BrunoCoelho98/maquete-iot-cidades-inteligentes/atividade/documentos/Questionario_antes.docx

Questionário — Internet das Coisas

Aplicação: antes da atividade

ANTES DE COMEÇAR

- Isto não é prova e não vale nota. Queremos saber o que a atividade ensina — não avaliar você.
- Se não souber uma resposta, marque Não sei. Isso ajuda muito mais do que um chute.
- Responda sem ajuda e sem consultar nada.

## Parte A — Marque uma alternativa

1. O que é a Internet das Coisas (IoT)?

( ) a) Usar a internet no celular, no computador e na televisão, em qualquer lugar da casa.

( ) b) Um aplicativo que liga e desliga, pelo celular, todos os aparelhos elétricos de uma casa.

( ) c) Objetos do dia a dia que percebem o ambiente, trocam informações pela rede e podem agir.

( ) d) A rede de computadores que as grandes empresas de tecnologia usam para guardar seus dados.

( ) Não sei

2. Em um sistema de IoT, qual destes é um SENSOR?

( ) a) Uma lâmpada que acende.

( ) b) Um motor que abre um portão.

( ) c) Uma sirene que toca.

( ) d) Um detector de presença.

( ) Não sei

3. E qual destes é um ATUADOR?

( ) a) Uma luz que acende para avisar.

( ) b) Um termômetro digital de parede.

( ) c) Um botão de campainha na porta.

( ) d) Um sensor de chuva no telhado.

( ) Não sei

4. Qual é o papel de um microcontrolador, como o ESP32, dentro de um objeto inteligente?

( ) a) Guardar a energia que o circuito usa, como uma bateria, para ele funcionar sem tomada.

( ) b) Executar um programa que lê os sensores, decide o que fazer e comanda os atuadores.

( ) c) Mostrar as informações em uma tela, para que o usuário acompanhe o que acontece.

( ) d) Transformar a energia elétrica em luz, calor ou movimento, conforme o que estiver ligado.

( ) Não sei

5. Como o microcontrolador sabe o que fazer?

( ) a) Ele aprende sozinho, observando o ambiente ao redor.

( ) b) Ele copia o que os outros aparelhos da rede estão fazendo.

( ) c) Ele já sai da fábrica sabendo controlar qualquer coisa.

( ) d) Alguém grava nele um programa com as instruções.

( ) Não sei

6. Um sensor de vaga de estacionamento fica a 200 metros da central da prefeitura, sem nenhum fio ligando os dois. Como a informação chega até a central?

( ) a) Por uma rede sem fio, como o Wi-Fi.

( ) b) Não chega: sem fio, não existe comunicação.

( ) c) Alguém precisa ir até o sensor buscar a informação.

( ) d) Pelo GPS do celular de quem estacionou.

( ) Não sei

7. Em um sistema que usa o protocolo MQTT, o que é o broker?

( ) a) O sensor que mede a informação e a transforma em uma mensagem para ser enviada.

( ) b) O roteador de Wi-Fi, que espalha o sinal da internet para os aparelhos da casa.

( ) c) Um intermediário que recebe as mensagens e as entrega a quem pediu para recebê-las.

( ) d) O programa que recebe os números e desenha os gráficos e os botões na tela do painel.

( ) Não sei

8. Uma lixeira inteligente publica a mensagem CHEIA no tópico cidade/lixeira/estado. Quem recebe essa mensagem?

( ) a) Todos os aparelhos que estão conectados à internet.

( ) b) Só quem assinou o tópico cidade/lixeira/estado.

( ) c) Só o celular de quem mora mais perto da lixeira.

( ) d) Ninguém: ela fica guardada na lixeira até alguém buscar.

( ) Não sei

9. Para que serve o tópico de uma mensagem MQTT?

( ) a) Para proteger a mensagem com uma senha, de modo que ninguém de fora da rede consiga ler.

( ) b) Para medir a velocidade da internet no momento em que a mensagem é enviada.

( ) c) Para registrar o dia e a hora em que a mensagem foi enviada pelo aparelho.

( ) d) Para dizer o assunto da mensagem, para que ela chegue a quem se interessa por ele.

( ) Não sei

10. No painel de uma cidade inteligente, alguém clica em um botão na tela e uma luz acende lá na rua. Isso mostra que:

( ) a) a informação só consegue ir da rua para o painel, e nunca no sentido contrário, do painel para a rua.

( ) b) o painel está ligado à luz por um fio comprido, escondido embaixo da calçada.

( ) c) a informação pode ir nos dois sentidos: da rua para o painel e do painel para a rua.

( ) d) a luz tem uma pequena câmera que viu a pessoa clicar no botão da tela.

( ) Não sei

11. O painel da cidade mostra que um dos aparelhos está OFFLINE. O que isso provavelmente quer dizer?

( ) a) O aparelho perdeu a conexão com a central: foi desligado, ficou sem Wi-Fi ou travou.

( ) b) O aparelho está funcionando normalmente, só que ninguém está usando ele agora.

( ) c) O aparelho está economizando energia de propósito e volta sozinho quando precisar.

( ) d) O painel está com defeito e mostra a informação errada para todos os aparelhos.

( ) Não sei

12. Uma cidade quer acrescentar um serviço novo a um sistema de IoT que já funciona. Em um sistema bem projetado:

( ) a) é preciso desligar e reprogramar todos os outros aparelhos da cidade para aceitar o novo.

( ) b) basta o novo aparelho seguir as mesmas regras de comunicação que os outros já seguem.

( ) c) o novo aparelho precisa ser ligado por fio a cada um dos aparelhos que já existem.

( ) d) é impossível: um sistema só funciona com os aparelhos que vieram com ele de fábrica.

( ) Não sei

## Parte B — Responda com as suas palavras

13. Em um ponto de ônibus inteligente, um passageiro aperta um botão e, pouco depois, aparece um aviso na tela da central. Numere de 1 a 5 a ordem em que a informação viaja:

Nº | Passo
| O broker recebe a mensagem e a entrega a quem assinou aquele tópico.
| O passageiro aperta o botão.
| A tela da central mostra "passageiro aguardando".
| O microcontrolador percebe o botão e publica uma mensagem pelo Wi-Fi.
| O programa da central (por exemplo, o Node-RED) recebe a mensagem.

14. Uma prefeitura quer lixeiras que avisem a central quando estiverem cheias. Cada lixeira também tem uma luz, que a central acende quando o caminhão de coleta está a caminho. Nesse sistema:

a) Qual é o sensor?

b) Qual é o atuador?

c) Invente um nome de tópico para a lixeira avisar que está cheia.

d) Que mensagem a central mandaria para a lixeira quando o caminhão sair?

15. Explique com as suas palavras o que acontece desde o momento em que alguém aperta o botão de um ponto de ônibus inteligente até a luz do ponto piscar, avisando que o ônibus está vindo.

## Parte C — Quanto você se sente capaz

Marque um número: 1 = nada confiante · 5 = muito confiante.

Eu conseguiria explicar para um colega… | 1 | 2 | 3 | 4 | 5
C1 o que é a Internet das Coisas. | ○ | ○ | ○ | ○ | ○
C2 a diferença entre um sensor e um atuador. | ○ | ○ | ○ | ○ | ○
C3 o que faz um microcontrolador. | ○ | ○ | ○ | ○ | ○
C4 como uma mensagem sai de um aparelho e chega a um painel na tela. | ○ | ○ | ○ | ○ | ○
C5 o que são o broker e o tópico no MQTT. | ○ | ○ | ○ | ○ | ○

Eu conseguiria… | 1 | 2 | 3 | 4 | 5
C6 montar um circuito simples seguindo um passo a passo. | ○ | ○ | ○ | ○ | ○

Obrigado!

Mini Smart City · Questionário · aplicação PRÉ · página 1
