BrunoCoelho98/maquete-iot-cidades-inteligentes/atividade/figuras/caminho_mensagem.png

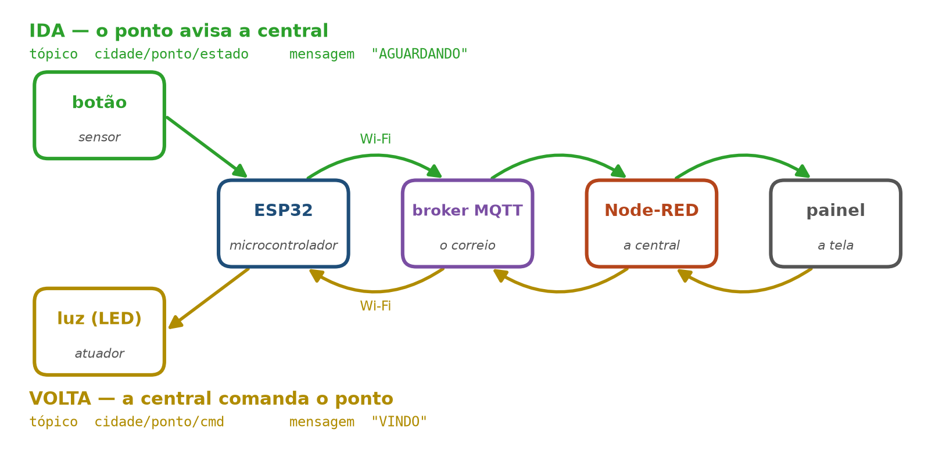
atividade/figuras/caminho_mensagem.png
