BrunoCoelho98/maquete-iot-cidades-inteligentes/esquematicos/png/placa1A_sinaleiras.png

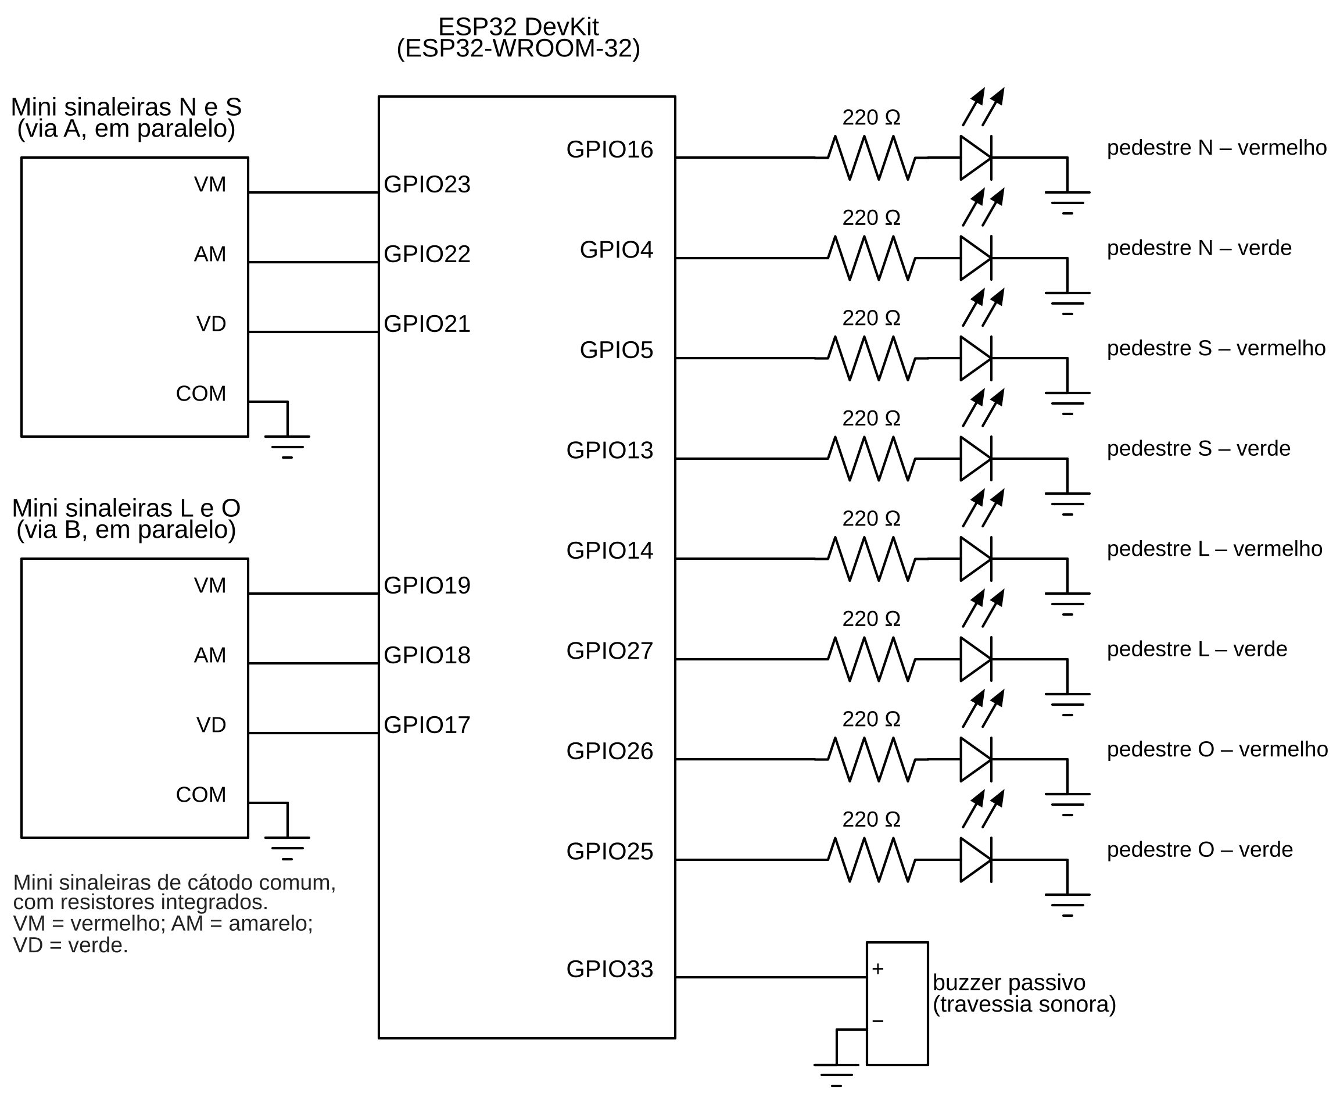
esquematicos/png/placa1A_sinaleiras.png
