BrunoCoelho98/maquete-iot-cidades-inteligentes/esquematicos/png/placa1B_sensores.png

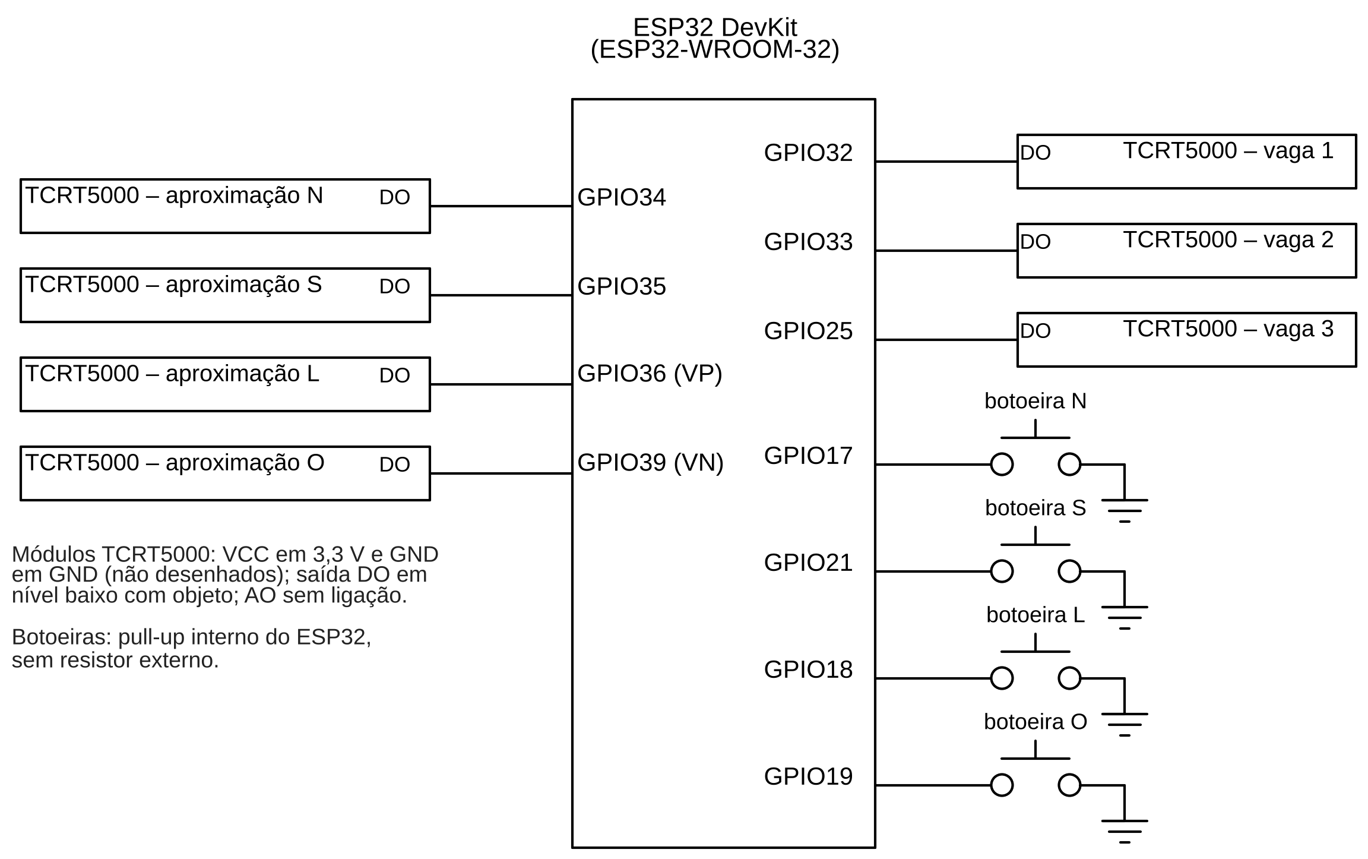
esquematicos/png/placa1B_sensores.png
