BrunoCoelho98/maquete-iot-cidades-inteligentes/esquematicos/png/placa2_iluminacao.png

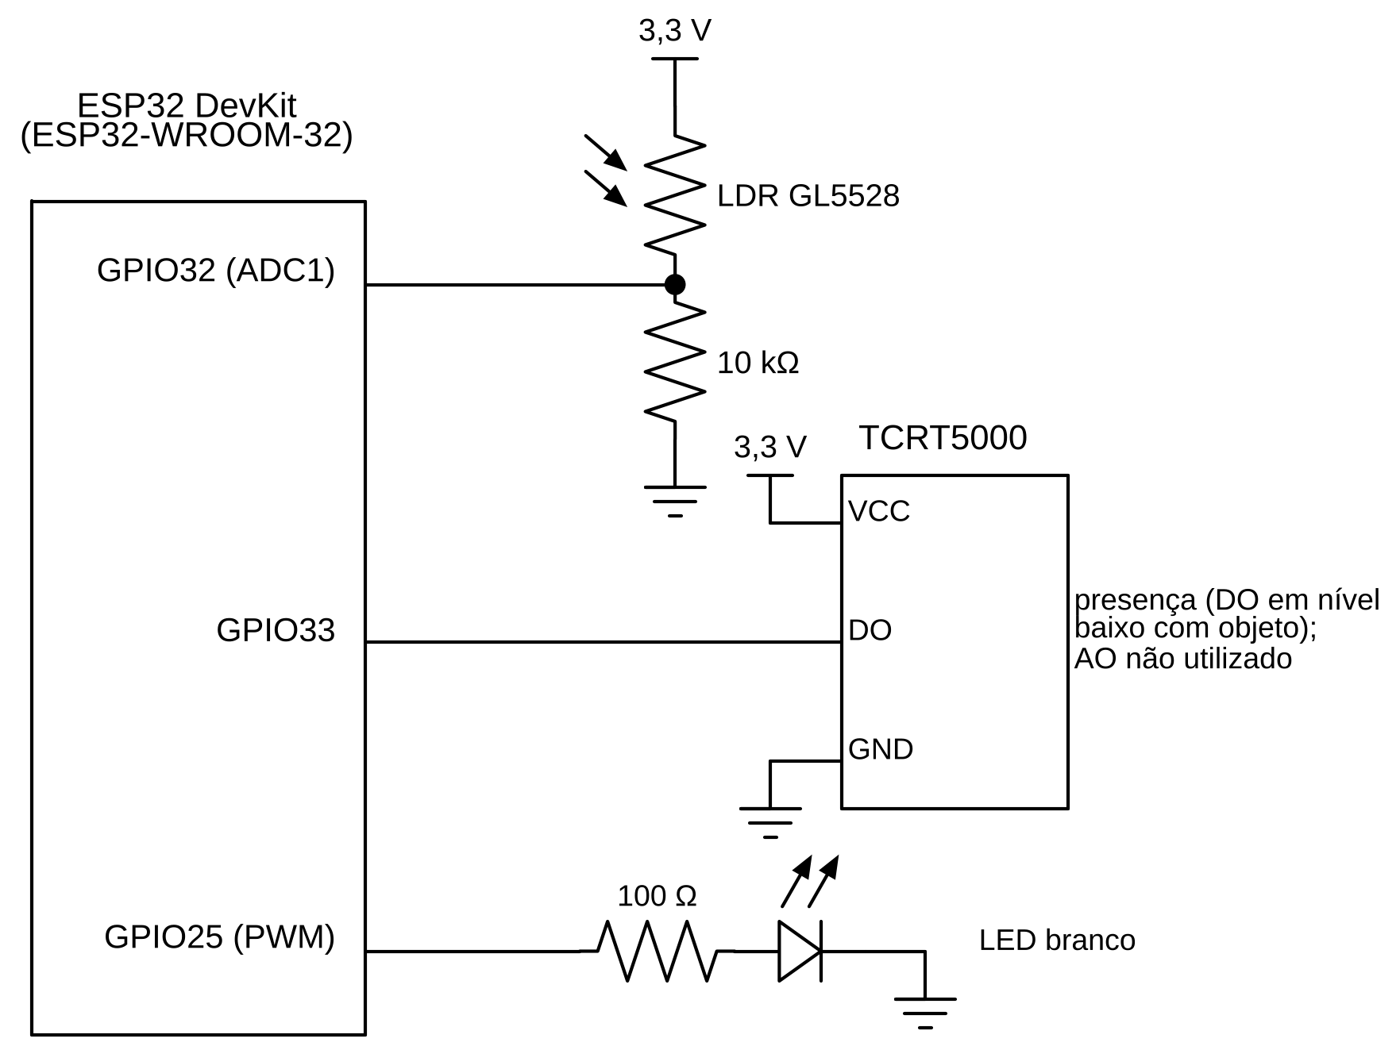
esquematicos/png/placa2_iluminacao.png
