BrunoCoelho98/maquete-iot-cidades-inteligentes/esquematicos/png/placa3_ambiental.png

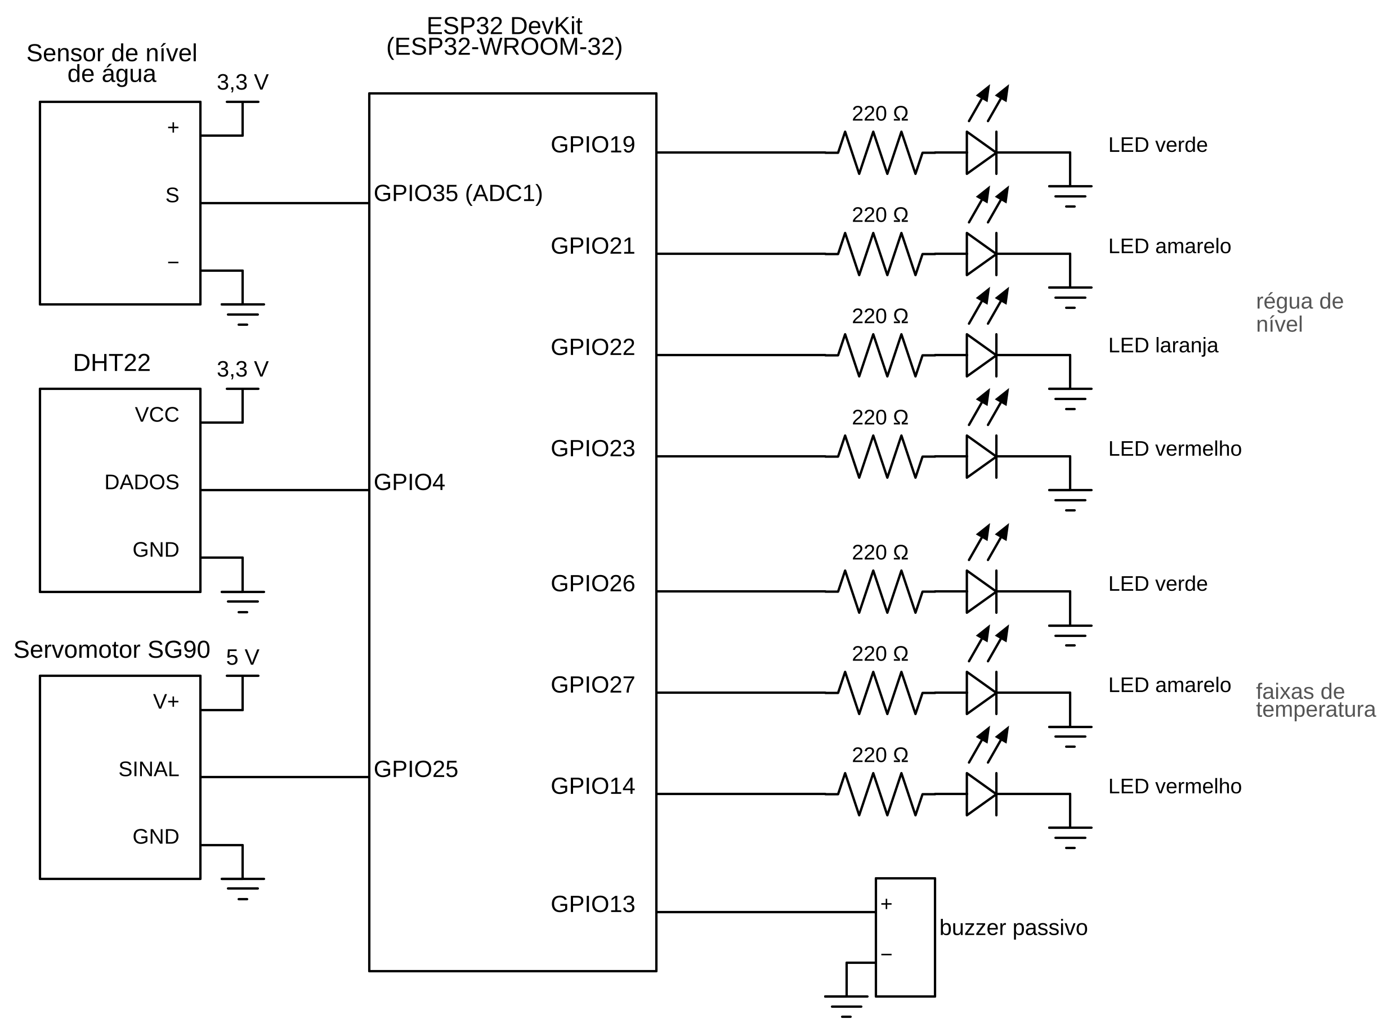
esquematicos/png/placa3_ambiental.png
