BrunoCoelho98/maquete-iot-cidades-inteligentes/esquematicos/png/placa4_seguranca.png

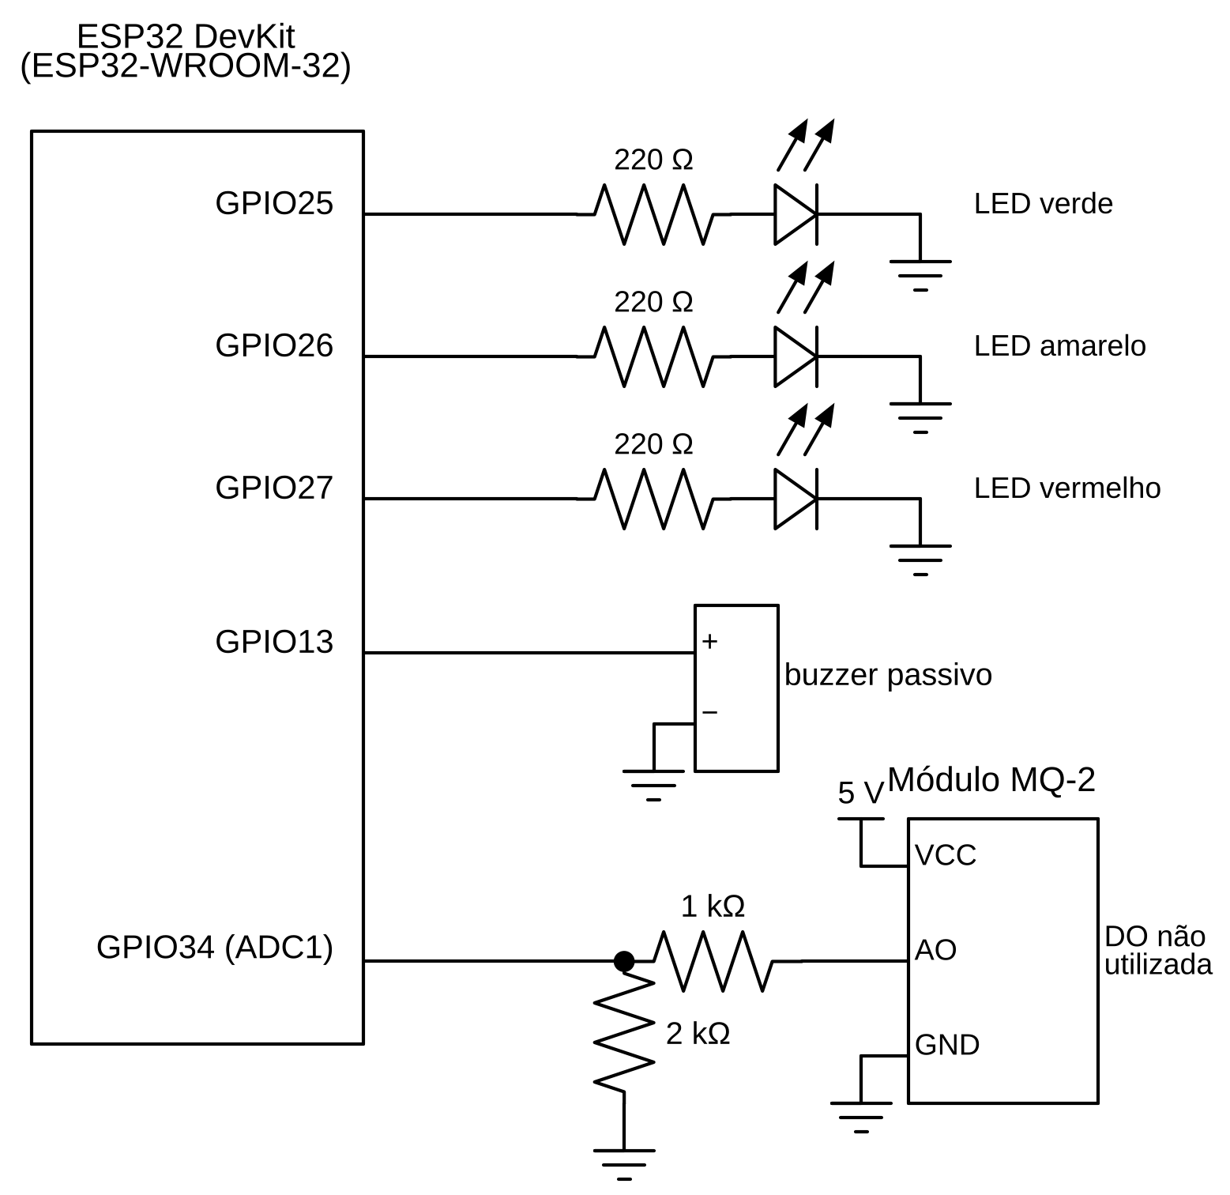
esquematicos/png/placa4_seguranca.png
