BrunoCoelho98/maquete-iot-cidades-inteligentes/layout/placa1A_1_veiculos.png

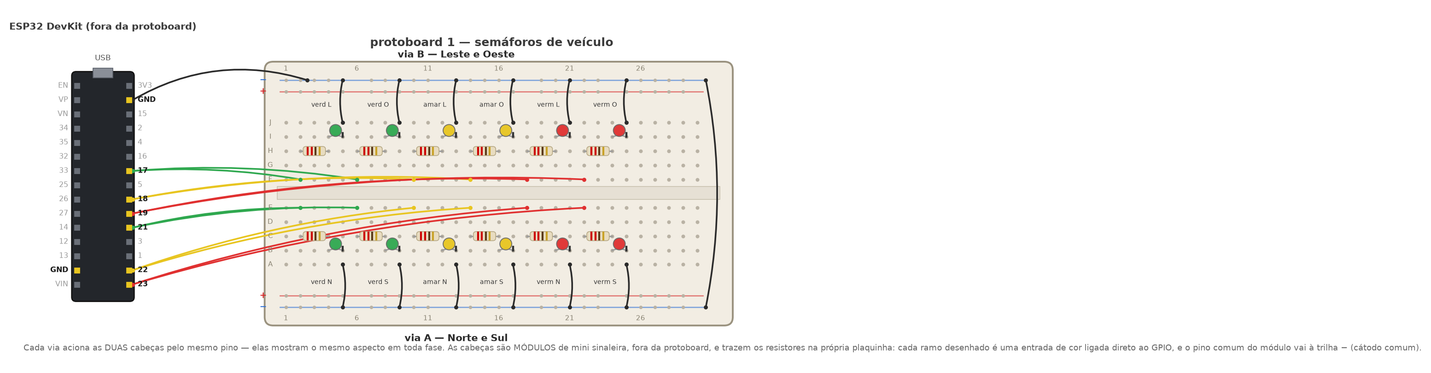
layout/placa1A_1_veiculos.png
