BrunoCoelho98/maquete-iot-cidades-inteligentes/layout/placa1A_2_pedestres.png

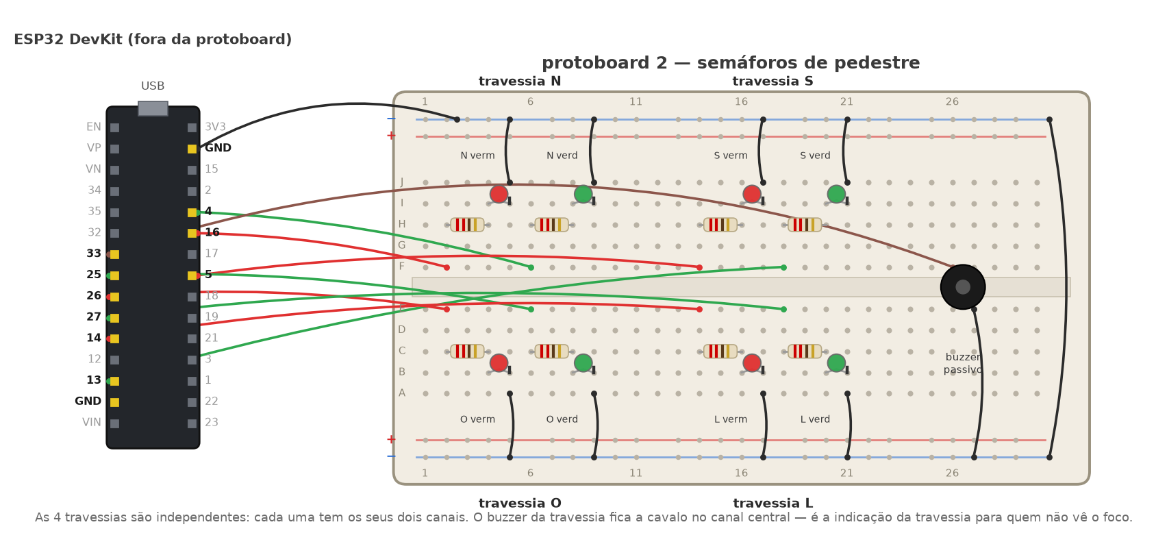
layout/placa1A_2_pedestres.png
