BrunoCoelho98/maquete-iot-cidades-inteligentes/esquematicos/pdf/iluminacao.pdf

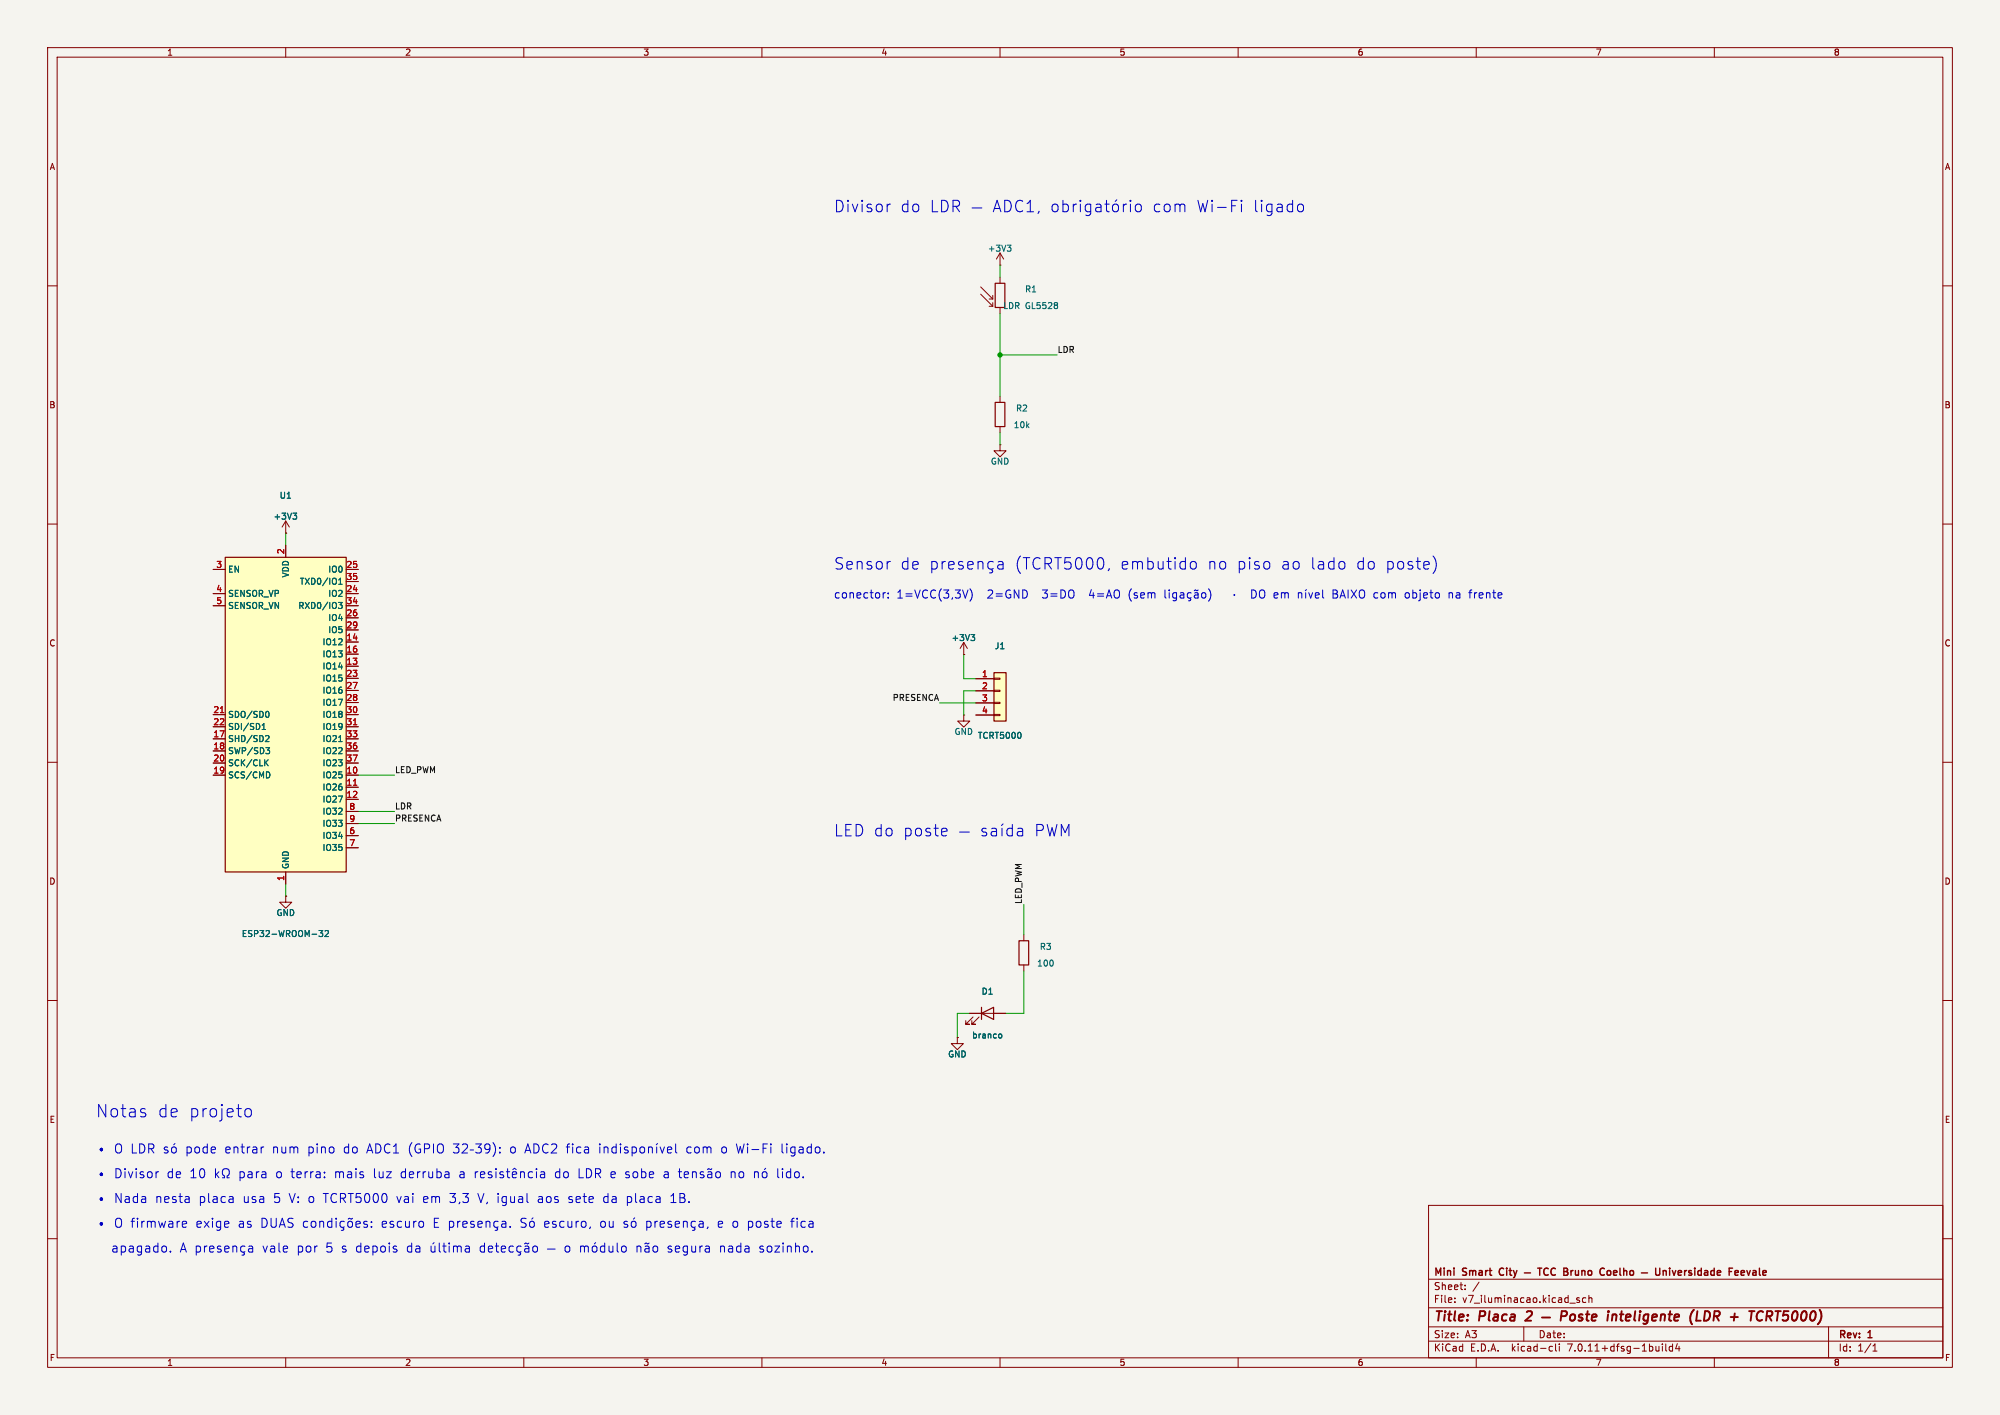
[picture p29: page 1]

Divisor do LDR þÿ ADC1, þÿobrigatório com Wi-Fi ligado

2 SCK/CLK 20 SDO/SD0 21 SDI/SD1 22

Sensor de þÿpresença (TCRT5000, embutido no piso ao lado do poste)

LED do poste þÿ þÿsaída PWM

þÿ "O LDR þÿsópode entrar num pino do ADC1 (GPIO þÿ32 39): o ADC2 fica þÿindisponível com o Wi-Fi ligado.
þÿ "Divisor de 10 þÿk©para o terra: mais luz derruba a þÿresistência do LDR e sobe a þÿtensão no þÿnólido.
þÿ "Nada nesta placa usa 5 V: o TCRT5000 vai em 3,3 V, igual aos sete da placa 1B.
þÿ "O firmware exige as DUAS þÿcondições: escuro E þÿpresença. þÿSóescuro, ou þÿsóþÿpresença, e o poste fica
apagado. A þÿpresença vale por 5 s depois da þÿúltima þÿdetecção þÿ  þÿmódulo þÿnãosegura nada sozinho.
