BrunoCoelho98/maquete-iot-cidades-inteligentes/esquematicos/pdf/seguranca.pdf

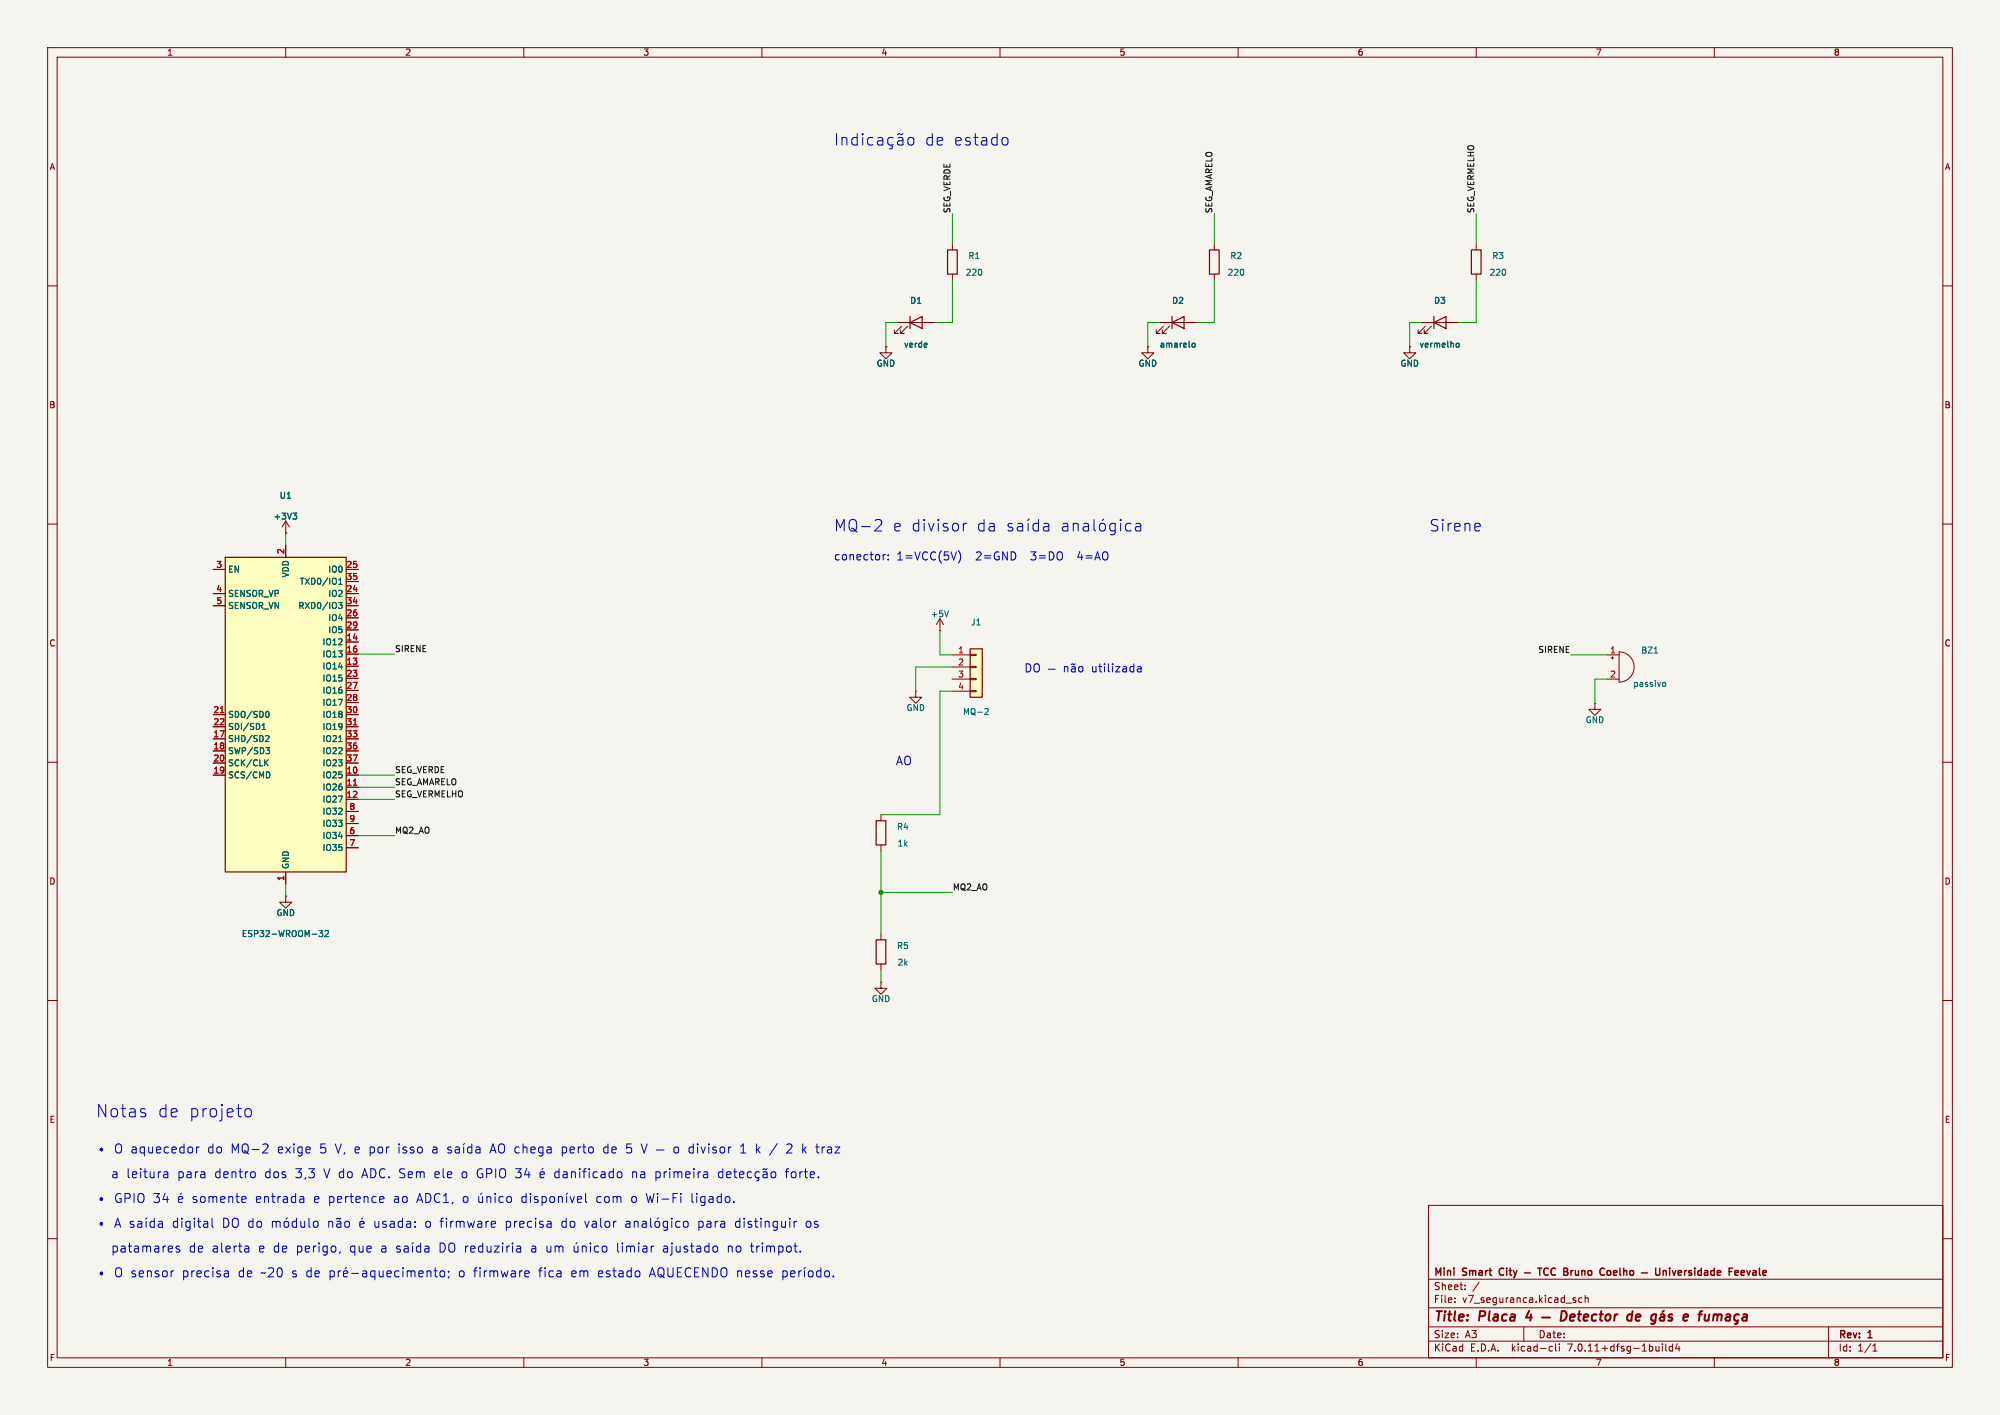
[picture p30: page 1]

MQ-2 e divisor da þÿsaída þÿanalógica

2 SCK/CLK 20 SDO/SD0 21 SDI/SD1 22

DO þÿ þÿnãoutilizada

þÿ "O aquecedor do MQ-2 exige 5 V, e por isso a þÿsaída AO chega perto de 5 V þÿ o divisor 1 k / 2 k traz

þÿ "O sensor precisa de ~20 s de þÿpré-aquecimento; o firmware fica em estado AQUECENDO nesse þÿperíodo.

File: v7_seguranca.kicad_sch Sheet: / Mini Smart City þÿ TCC Bruno Coelho þÿ Universidade Feevale

Id: 1/1 Title: Placa 4 þÿ Detector de þÿgáse þÿfumaça
