BrunoCoelho98/maquete-iot-cidades-inteligentes/esquematicos/pdf/sensores.pdf

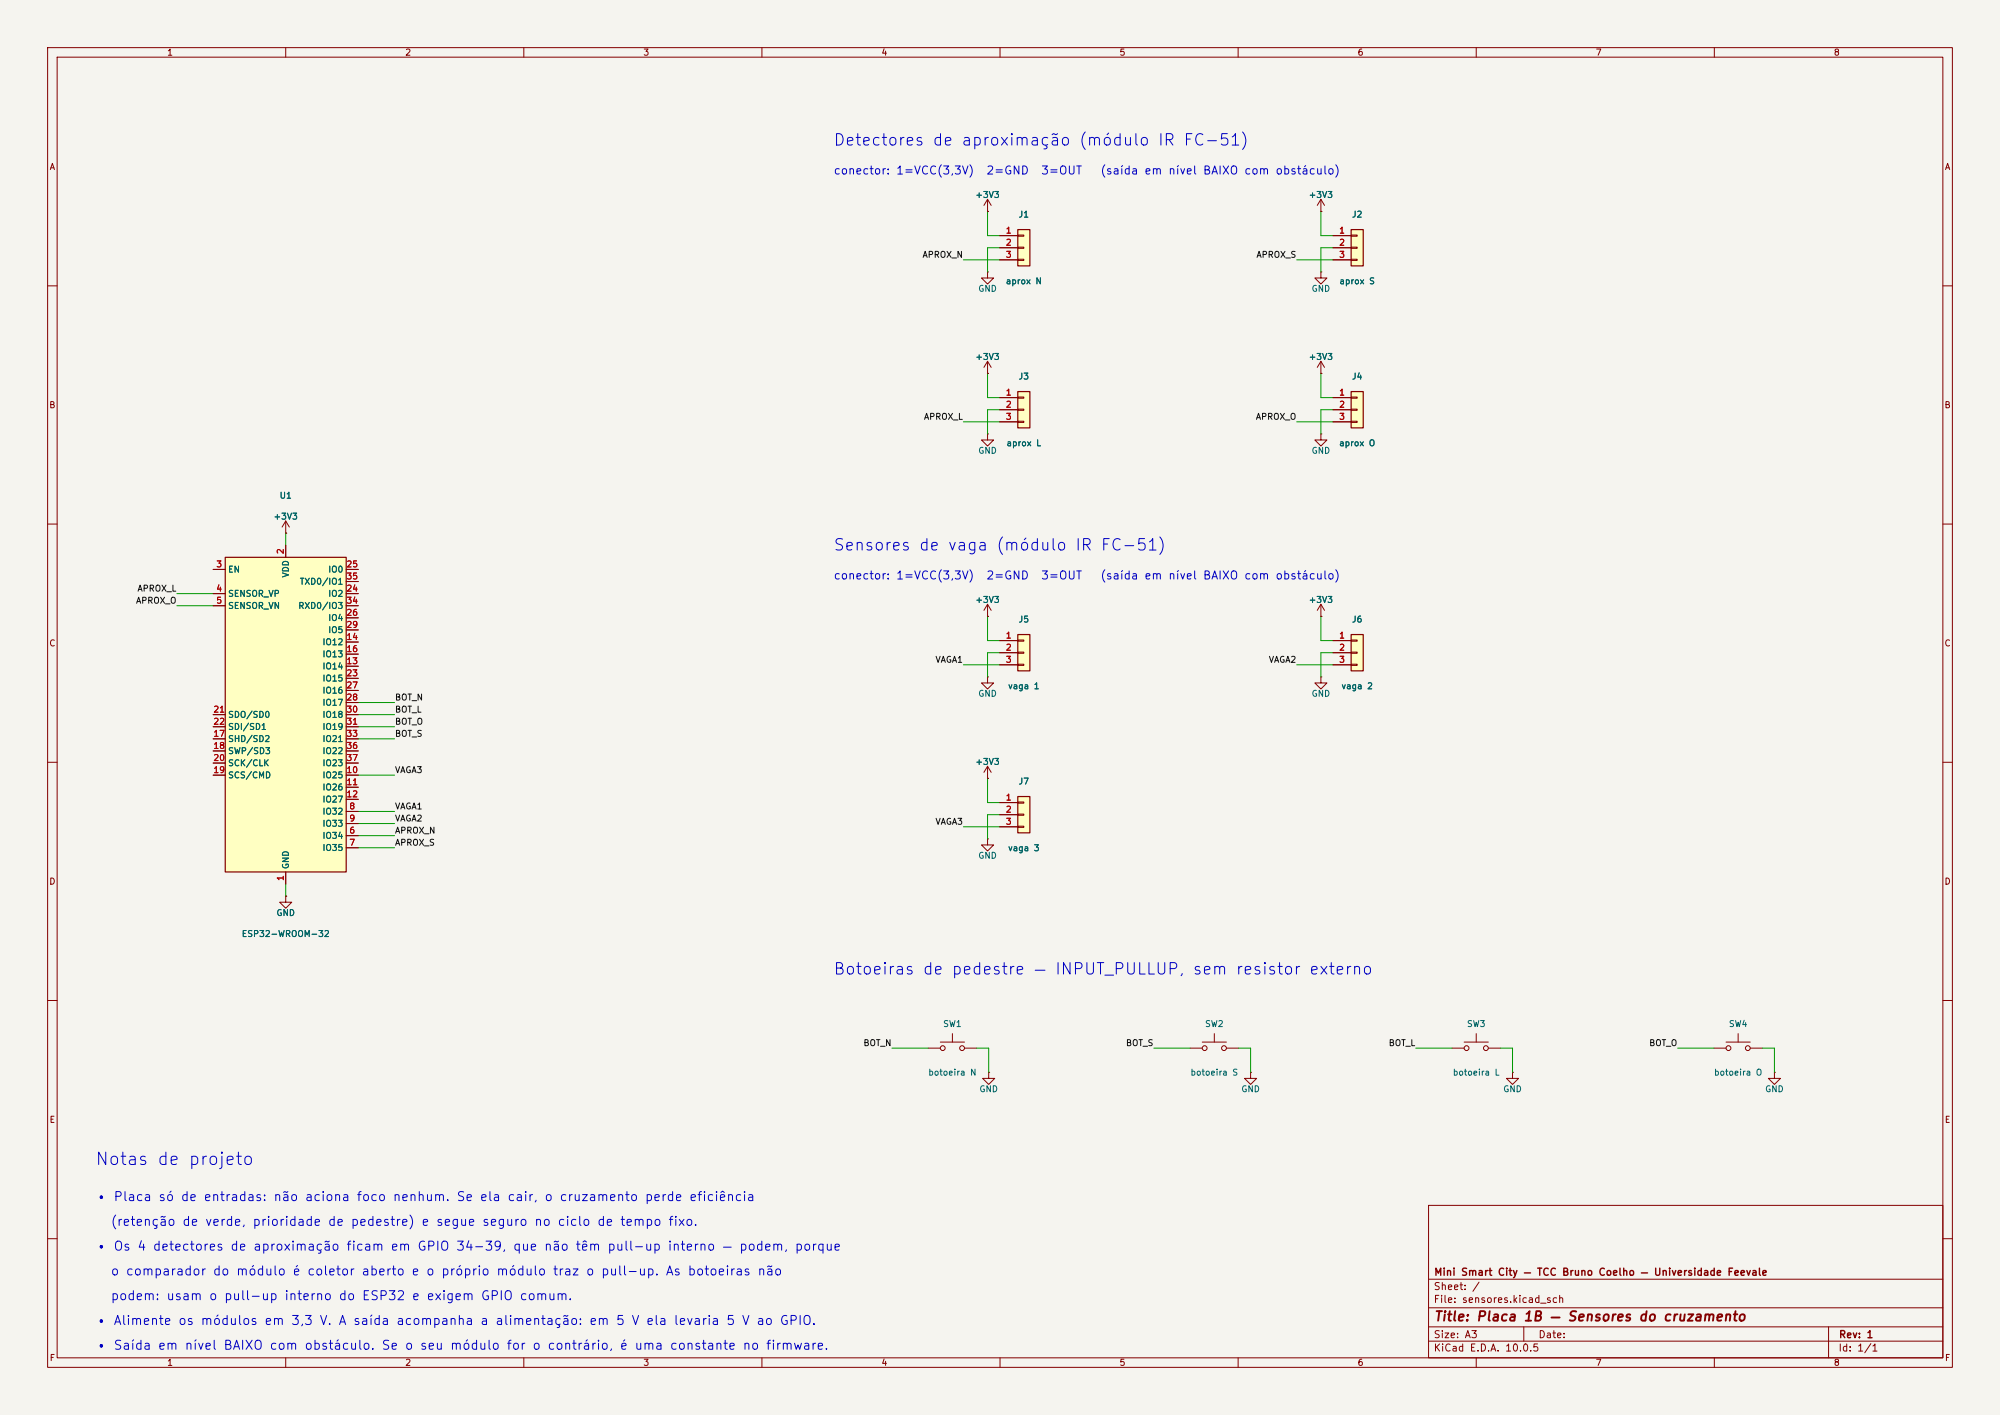
[picture p32: page 1]

Detectores de aproximação (módulo IR FC-51)

Sensores de vaga (módulo IR FC-51)

Botoeiras de pedestre — INPUT_PULLUP, sem resistor externo • Os 4 detectores de aproximação ficam em GPIO 34-39, que não têm pull-up interno — podem, porque

podem: usam o pull-up interno do ESP32 e exigem GPIO comum. • Placa só de entradas: não aciona foco nenhum. Se ela cair, o cruzamento perde eficiência • Saída em nível BAIXO com obstáculo. Se o seu módulo for o contrário, é uma constante no firmware. o comparador do módulo é coletor aberto e o próprio módulo traz o pull-up. As botoeiras não

Mini Smart City — TCC Bruno Coelho — Universidade Feevale
Sheet: /
File: sensores.kicad_sch
Title: Placa 1B — Sensores do cruzamento

• Alimente os módulos em 3,3 V. A saída acompanha a alimentação: em 5 V ela levaria 5 V ao GPIO.

Size: A3 | Rev: 1 | F Date:
KiCad E.D.A. 10.0.5 | Id: 1/1
