BrunoCoelho98/maquete-iot-cidades-inteligentes/esquematicos/ambiental.kicad_sch

## KiCad design esquematicos/ambiental.kicad_sch (2026-11-01)

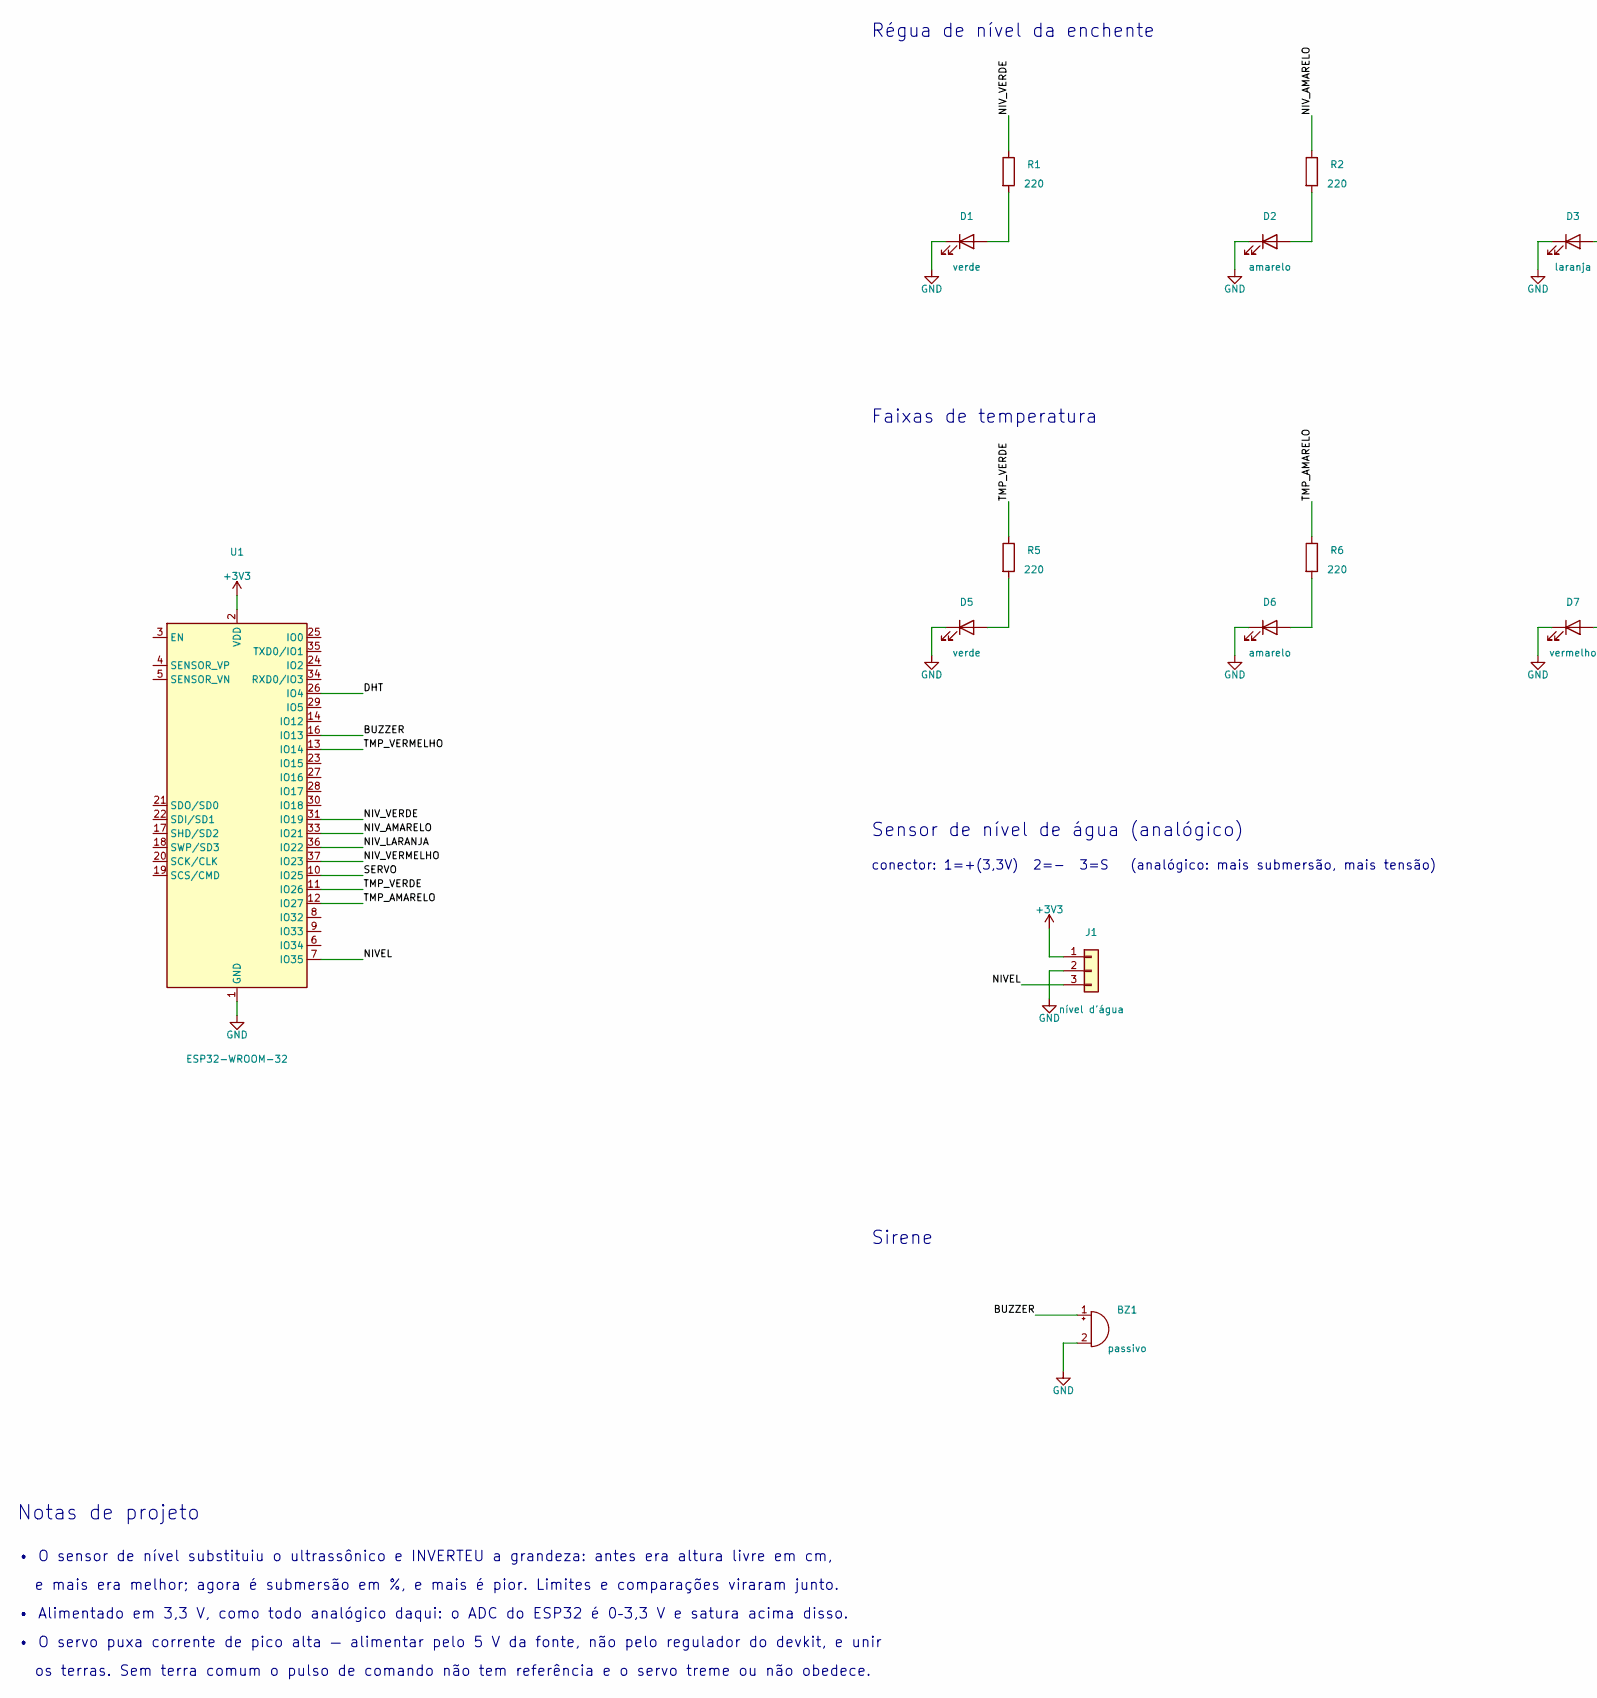
[picture p33: schematic ambiental.kicad_sch, part in row 1, column 1]

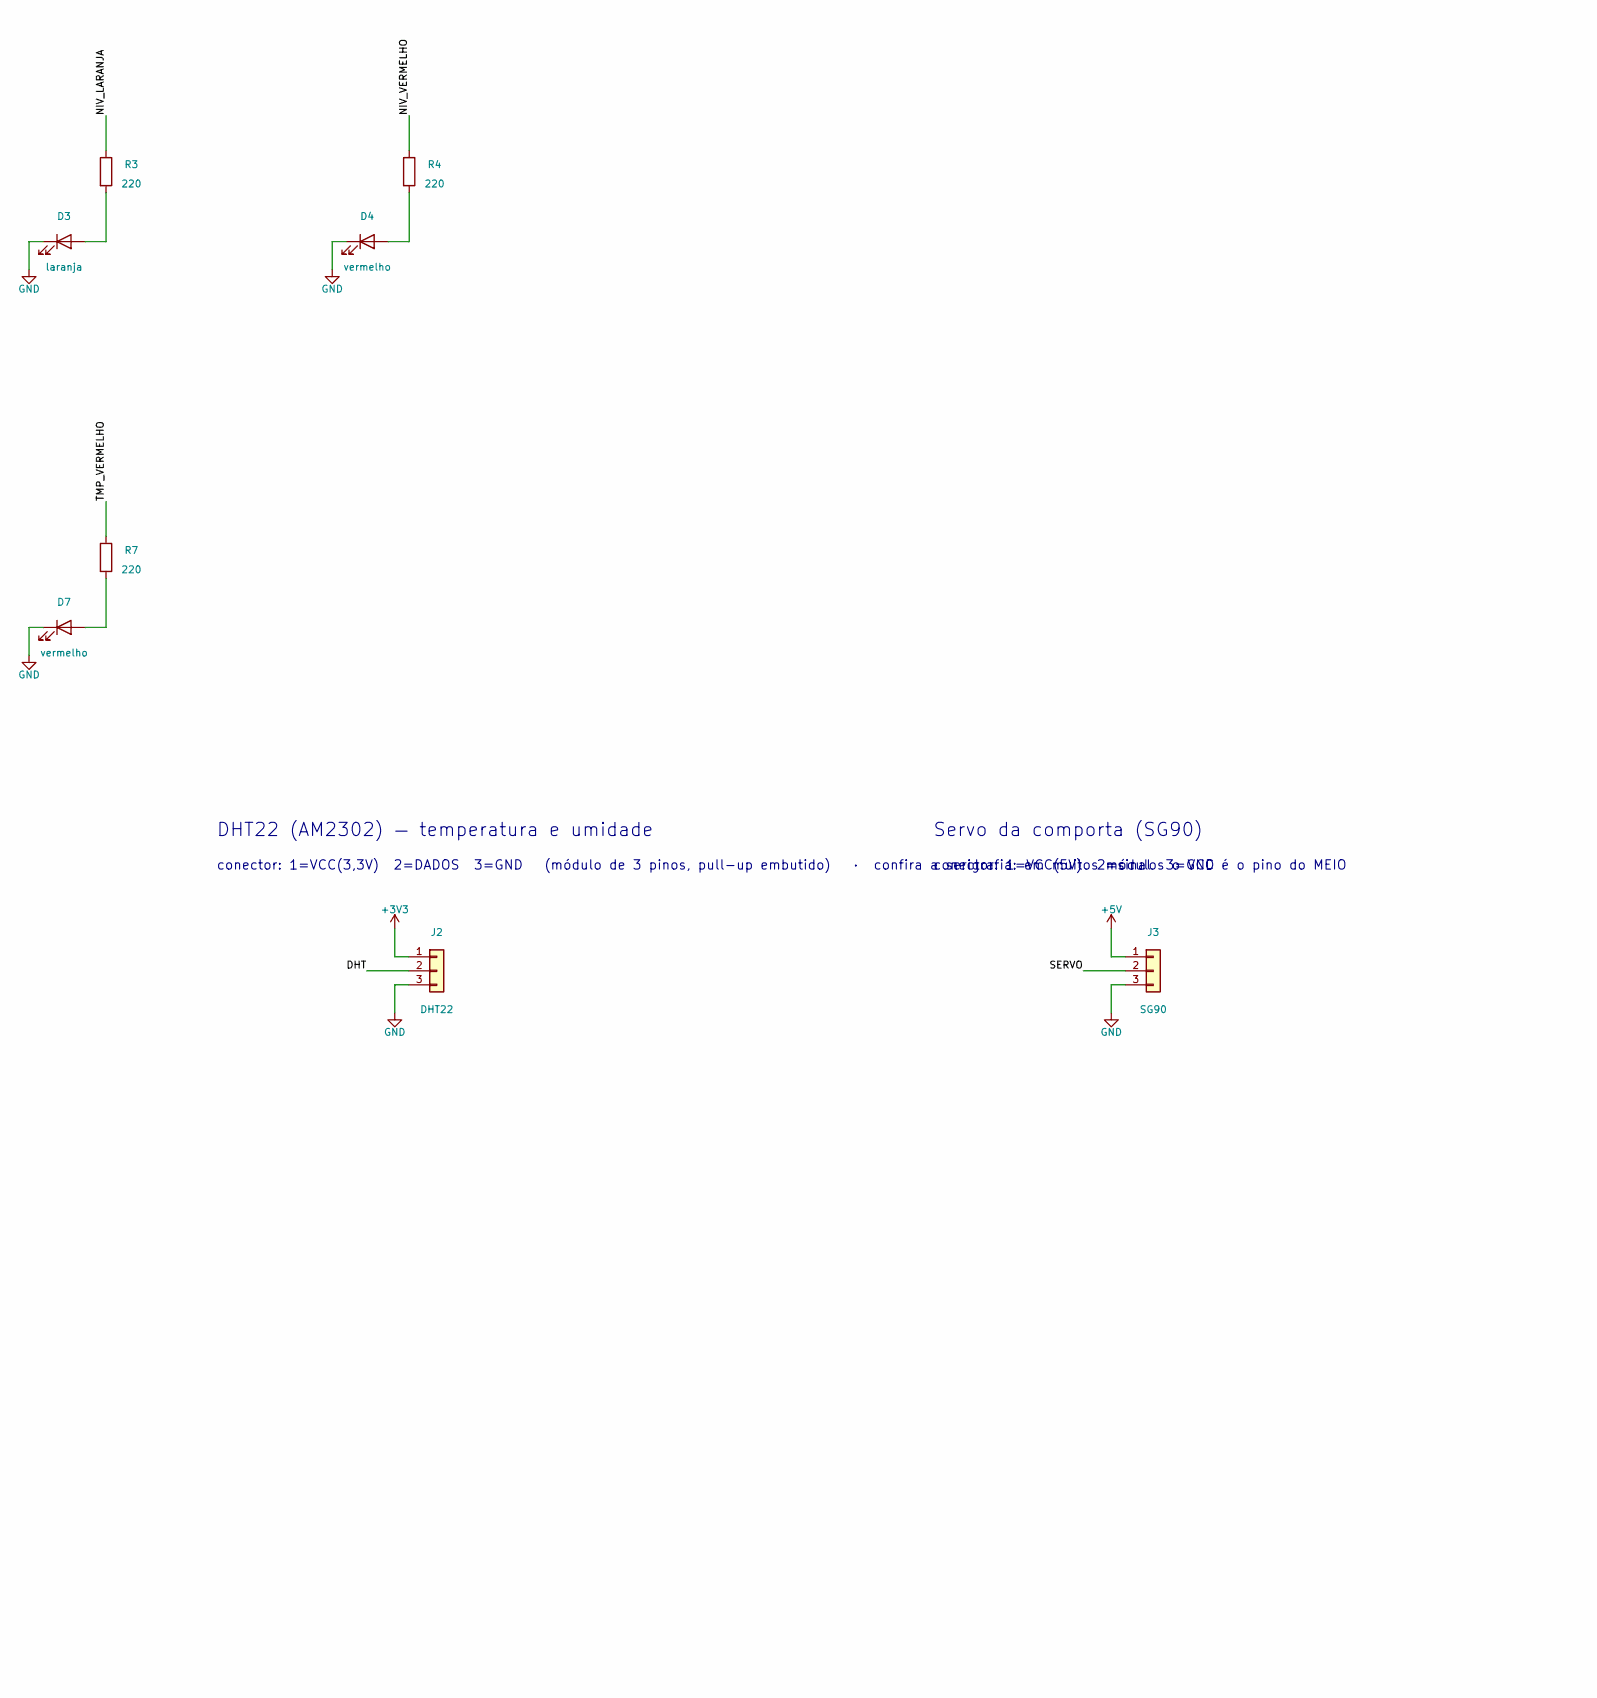
[picture p34: schematic ambiental.kicad_sch, part in row 1, column 2]

Parts:
BZ1: passivo
D1, D5: verde
D2, D6: amarelo
D3: laranja
D4, D7: vermelho
J1: nível d'água
J2: DHT22
J3: SG90
R1, R2, R3, R4, R5, R6, R7: 220
U1: ESP32-WROOM-32

Connections:
+3V3: J1.1, J2.1, U1.2 (VDD)
+5V: J3.1
BUZZER: BZ1.1 (+), U1.16 (IO13)
DHT: J2.2, U1.26 (IO4)
GND: BZ1.2 (-), D1.1 (K), D2.1 (K), D3.1 (K), D4.1 (K), D5.1 (K), D6.1 (K), D7.1 (K), J1.2, J2.3, J3.3, U1.1 (GND), U1.15 (GND), U1.38 (GND), U1.39 (GND)
NIVEL: J1.3, U1.7 (IO35)
NIV_AMARELO: R2.1, U1.33 (IO21)
NIV_LARANJA: R3.1, U1.36 (IO22)
NIV_VERDE: R1.1, U1.31 (IO19)
NIV_VERMELHO: R4.1, U1.37 (IO23)
unnamed: D1.2 (A), R1.2
unnamed: D2.2 (A), R2.2
unnamed: D3.2 (A), R3.2
unnamed: D4.2 (A), R4.2
unnamed: D5.2 (A), R5.2
unnamed: D6.2 (A), R6.2
unnamed: D7.2 (A), R7.2
SERVO: J3.2, U1.10 (IO25)
TMP_AMARELO: R6.1, U1.12 (IO27)
TMP_VERDE: R5.1, U1.11 (IO26)
TMP_VERMELHO: R7.1, U1.13 (IO14)

Notes on the sheet:
Régua de nível da enchente
Faixas de temperatura
Sensor de nível de água (analógico)
conector: 1=+(3,3V) 2=− 3=S (analógico: mais submersão, mais tensão)
DHT22 (AM2302) — temperatura e umidade
conector: 1=VCC(3,3V) 2=DADOS 3=GND (módulo de 3 pinos, pull-up embutido) · confira a serigrafia: em muitos módulos o VCC é o pino do MEIO
Servo da comporta (SG90)
conector: 1=VCC(5V) 2=sinal 3=GND
Sirene
Notas de projeto
• O sensor de nível substituiu o ultrassônico e INVERTEU a grandeza: antes era altura livre em cm,
e mais era melhor; agora é submersão em %, e mais é pior. Limites e comparações viraram junto.
• Alimentado em 3,3 V, como todo analógico daqui: o ADC do ESP32 é 0–3,3 V e satura acima disso.
• O servo puxa corrente de pico alta — alimentar pelo 5 V da fonte, não pelo regulador do devkit, e unir
os terras. Sem terra comum o pulso de comando não tem referência e o servo treme ou não obedece.
