BrunoCoelho98/maquete-iot-cidades-inteligentes/esquematicos/iluminacao.kicad_sch

## KiCad design esquematicos/iluminacao.kicad_sch (2026-11-10)

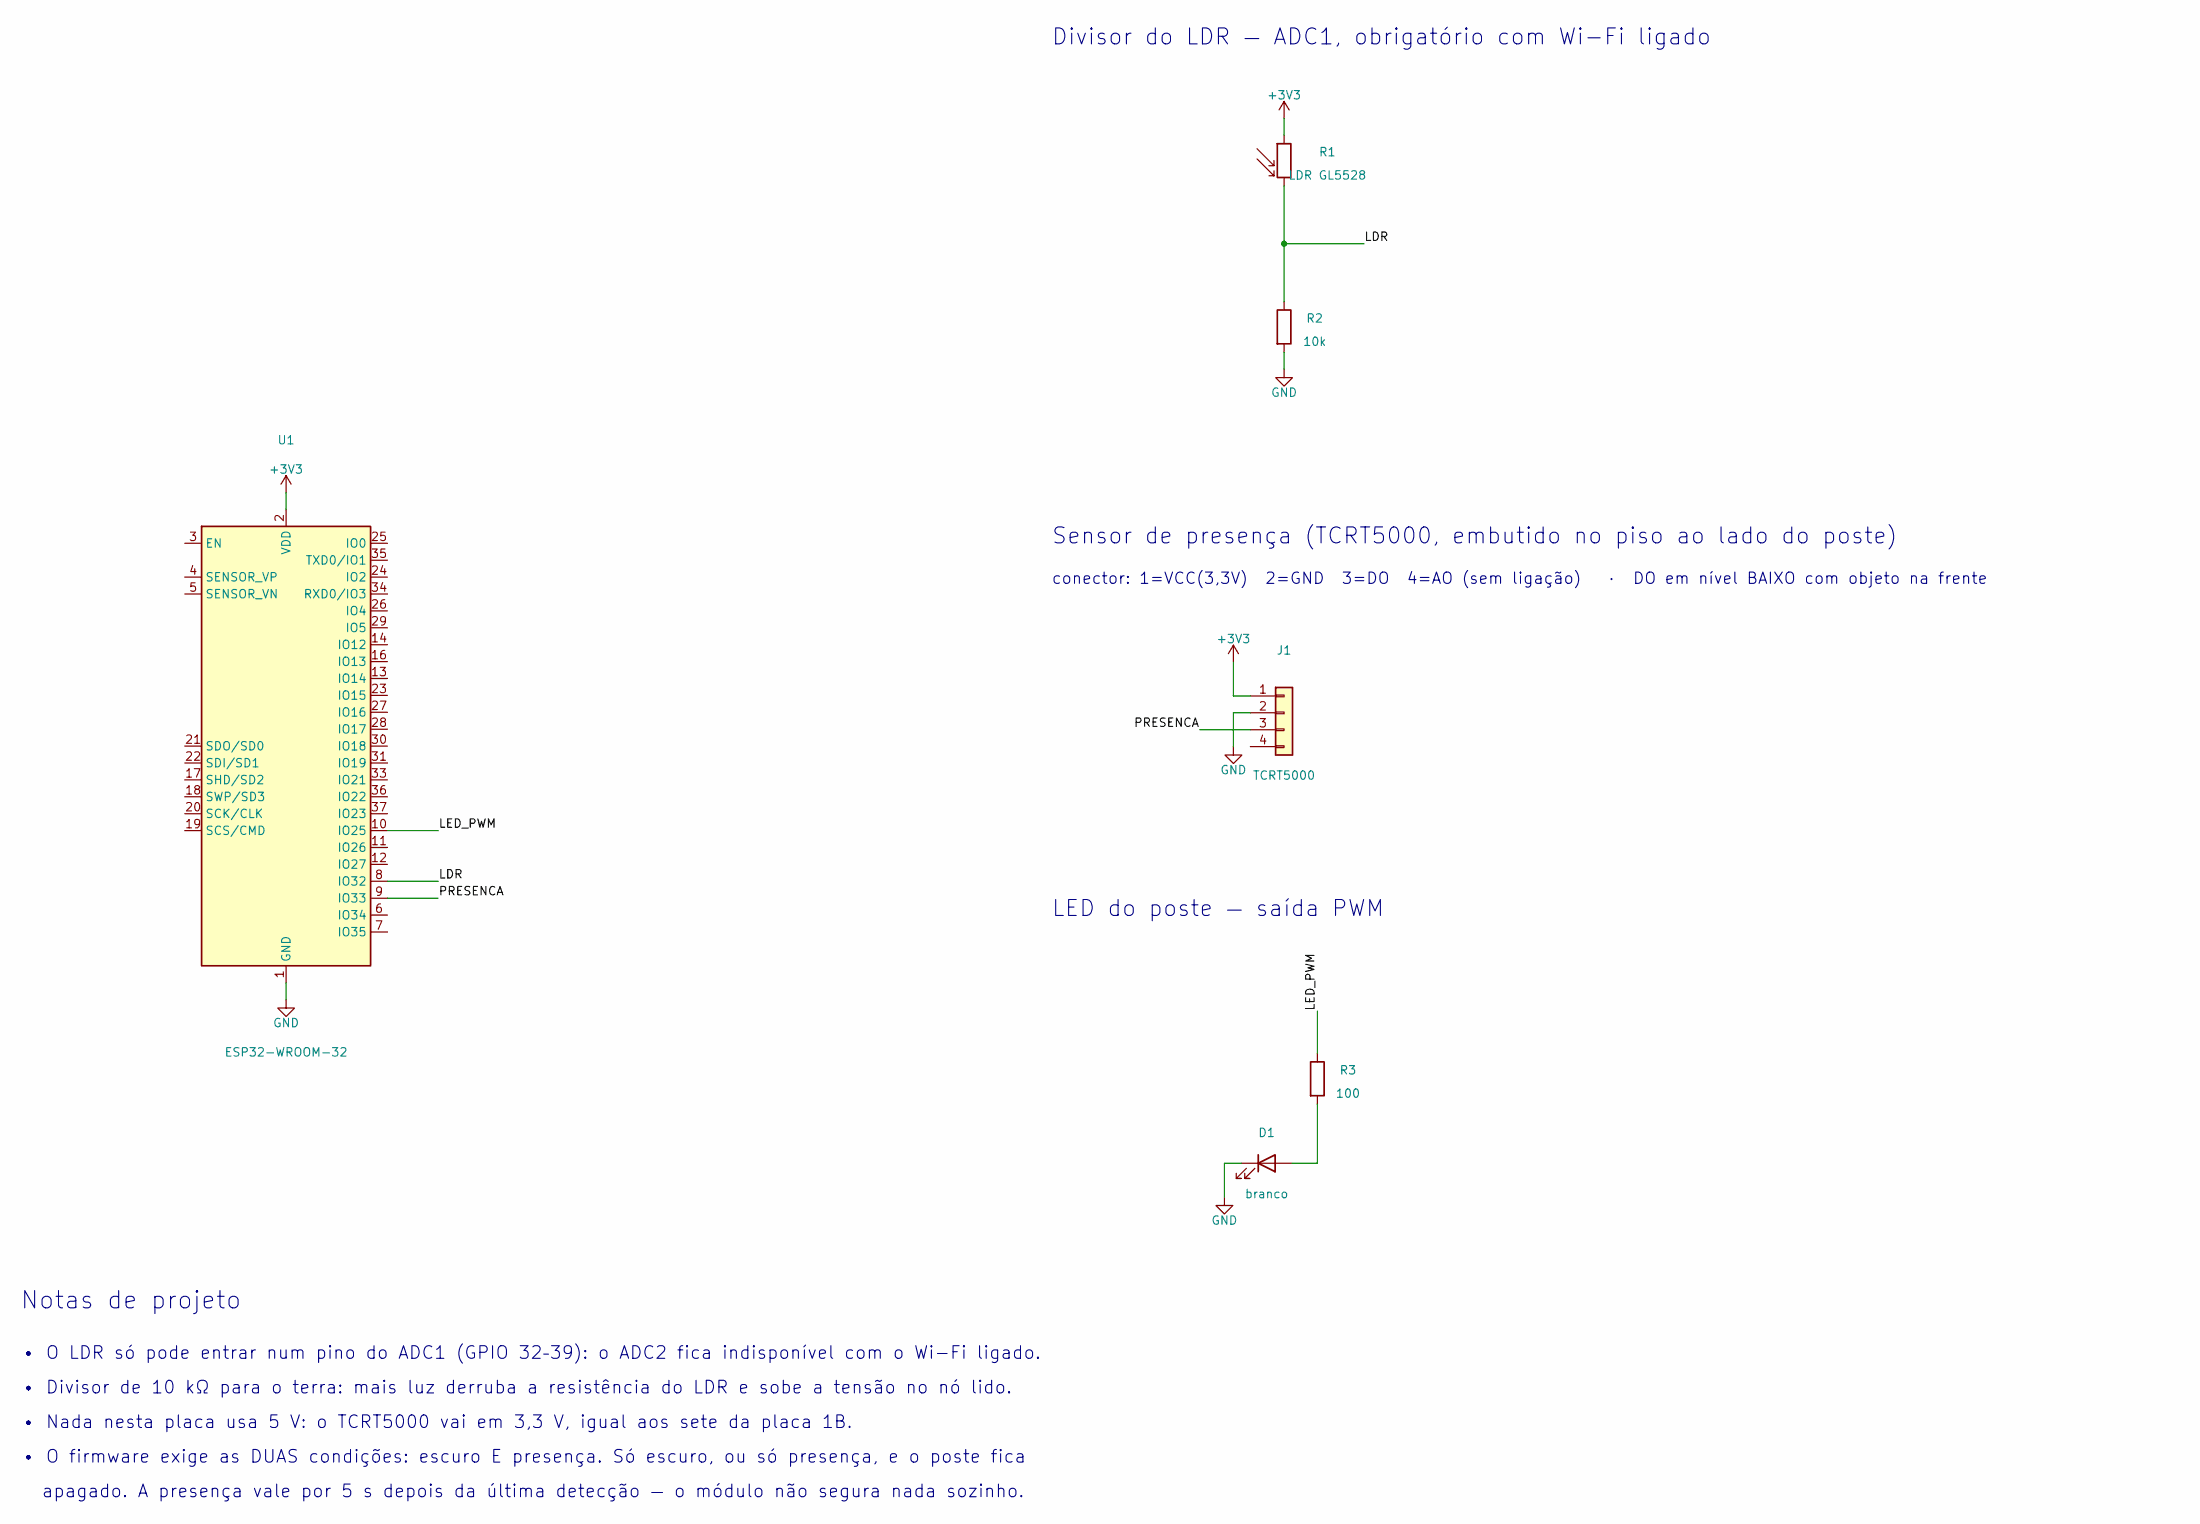
[picture p35: schematic iluminacao.kicad_sch]

Parts:
D1: branco
J1: TCRT5000
R1: LDR GL5528
R2: 10k
R3: 100
U1: ESP32-WROOM-32

Connections:
+3V3: J1.1, R1.1, U1.2 (VDD)
GND: D1.1 (K), J1.2, R2.2, U1.1 (GND), U1.15 (GND), U1.38 (GND), U1.39 (GND)
LDR: R1.2, R2.1, U1.8 (IO32)
LED_PWM: R3.1, U1.10 (IO25)
unnamed: D1.2 (A), R3.2
PRESENCA: J1.3, U1.9 (IO33)

Notes on the sheet:
Divisor do LDR — ADC1, obrigatório com Wi-Fi ligado
Sensor de presença (TCRT5000, embutido no piso ao lado do poste)
conector: 1=VCC(3,3V) 2=GND 3=DO 4=AO (sem ligação) · DO em nível BAIXO com objeto na frente
LED do poste — saída PWM
Notas de projeto
• O LDR só pode entrar num pino do ADC1 (GPIO 32–39): o ADC2 fica indisponível com o Wi-Fi ligado.
• Divisor de 10 kΩ para o terra: mais luz derruba a resistência do LDR e sobe a tensão no nó lido.
• Nada nesta placa usa 5 V: o TCRT5000 vai em 3,3 V, igual aos sete da placa 1B.
• O firmware exige as DUAS condições: escuro E presença. Só escuro, ou só presença, e o poste fica
apagado. A presença vale por 5 s depois da última detecção — o módulo não segura nada sozinho.
