BrunoCoelho98/maquete-iot-cidades-inteligentes/esquematicos/seguranca.kicad_sch

## KiCad design esquematicos/seguranca.kicad_sch (2026-11-10)

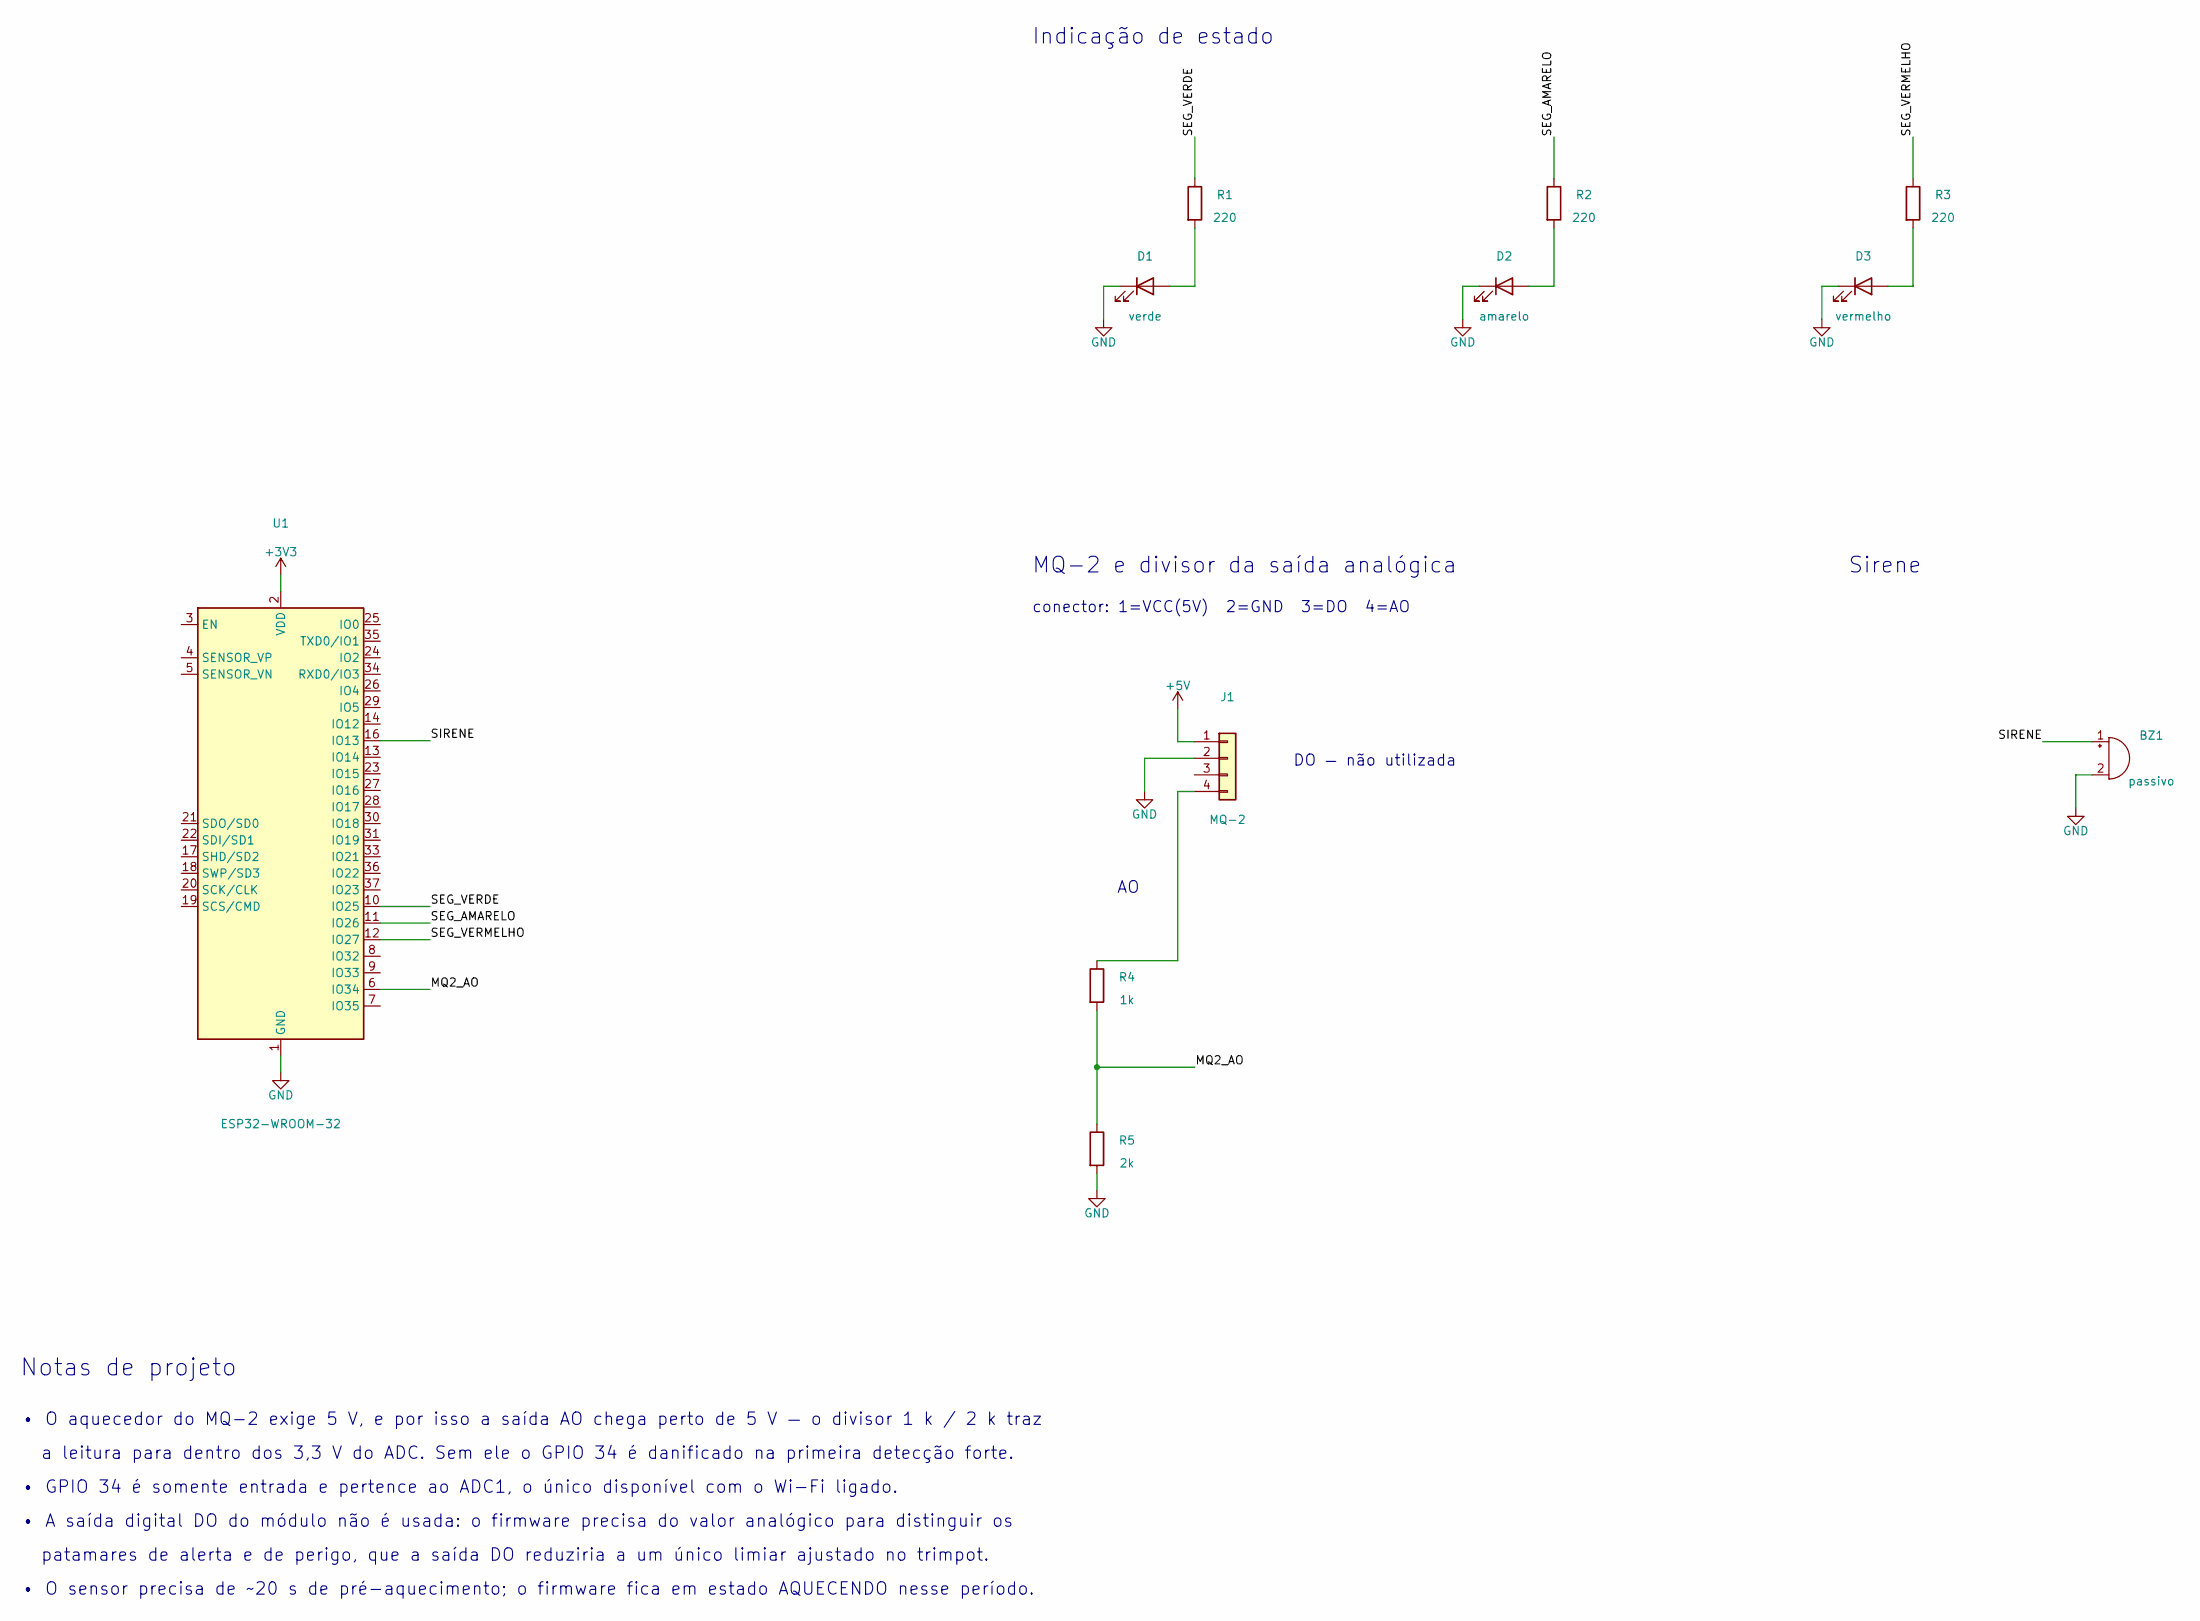
[picture p36: schematic seguranca.kicad_sch]

Parts:
BZ1: passivo
D1: verde
D2: amarelo
D3: vermelho
J1: MQ-2
R1, R2, R3: 220
R4: 1k
R5: 2k
U1: ESP32-WROOM-32

Connections:
+3V3: U1.2 (VDD)
+5V: J1.1
GND: BZ1.2 (-), D1.1 (K), D2.1 (K), D3.1 (K), J1.2, R5.2, U1.1 (GND), U1.15 (GND), U1.38 (GND), U1.39 (GND)
MQ2_AO: R4.2, R5.1, U1.6 (IO34)
unnamed: D1.2 (A), R1.2
unnamed: D2.2 (A), R2.2
unnamed: D3.2 (A), R3.2
unnamed: J1.4, R4.1
SEG_AMARELO: R2.1, U1.11 (IO26)
SEG_VERDE: R1.1, U1.10 (IO25)
SEG_VERMELHO: R3.1, U1.12 (IO27)
SIRENE: BZ1.1 (+), U1.16 (IO13)

Notes on the sheet:
Indicação de estado
MQ-2 e divisor da saída analógica
conector: 1=VCC(5V) 2=GND 3=DO 4=AO
DO — não utilizada
Sirene
Notas de projeto
• O aquecedor do MQ-2 exige 5 V, e por isso a saída AO chega perto de 5 V — o divisor 1 k / 2 k traz
a leitura para dentro dos 3,3 V do ADC. Sem ele o GPIO 34 é danificado na primeira detecção forte.
• GPIO 34 é somente entrada e pertence ao ADC1, o único disponível com o Wi-Fi ligado.
• A saída digital DO do módulo não é usada: o firmware precisa do valor analógico para distinguir os
patamares de alerta e de perigo, que a saída DO reduziria a um único limiar ajustado no trimpot.
• O sensor precisa de ~20 s de pré-aquecimento; o firmware fica em estado AQUECENDO nesse período.
