BrunoCoelho98/maquete-iot-cidades-inteligentes/esquematicos/sensores.kicad_sch

## KiCad design esquematicos/sensores.kicad_sch (2026-11-01)

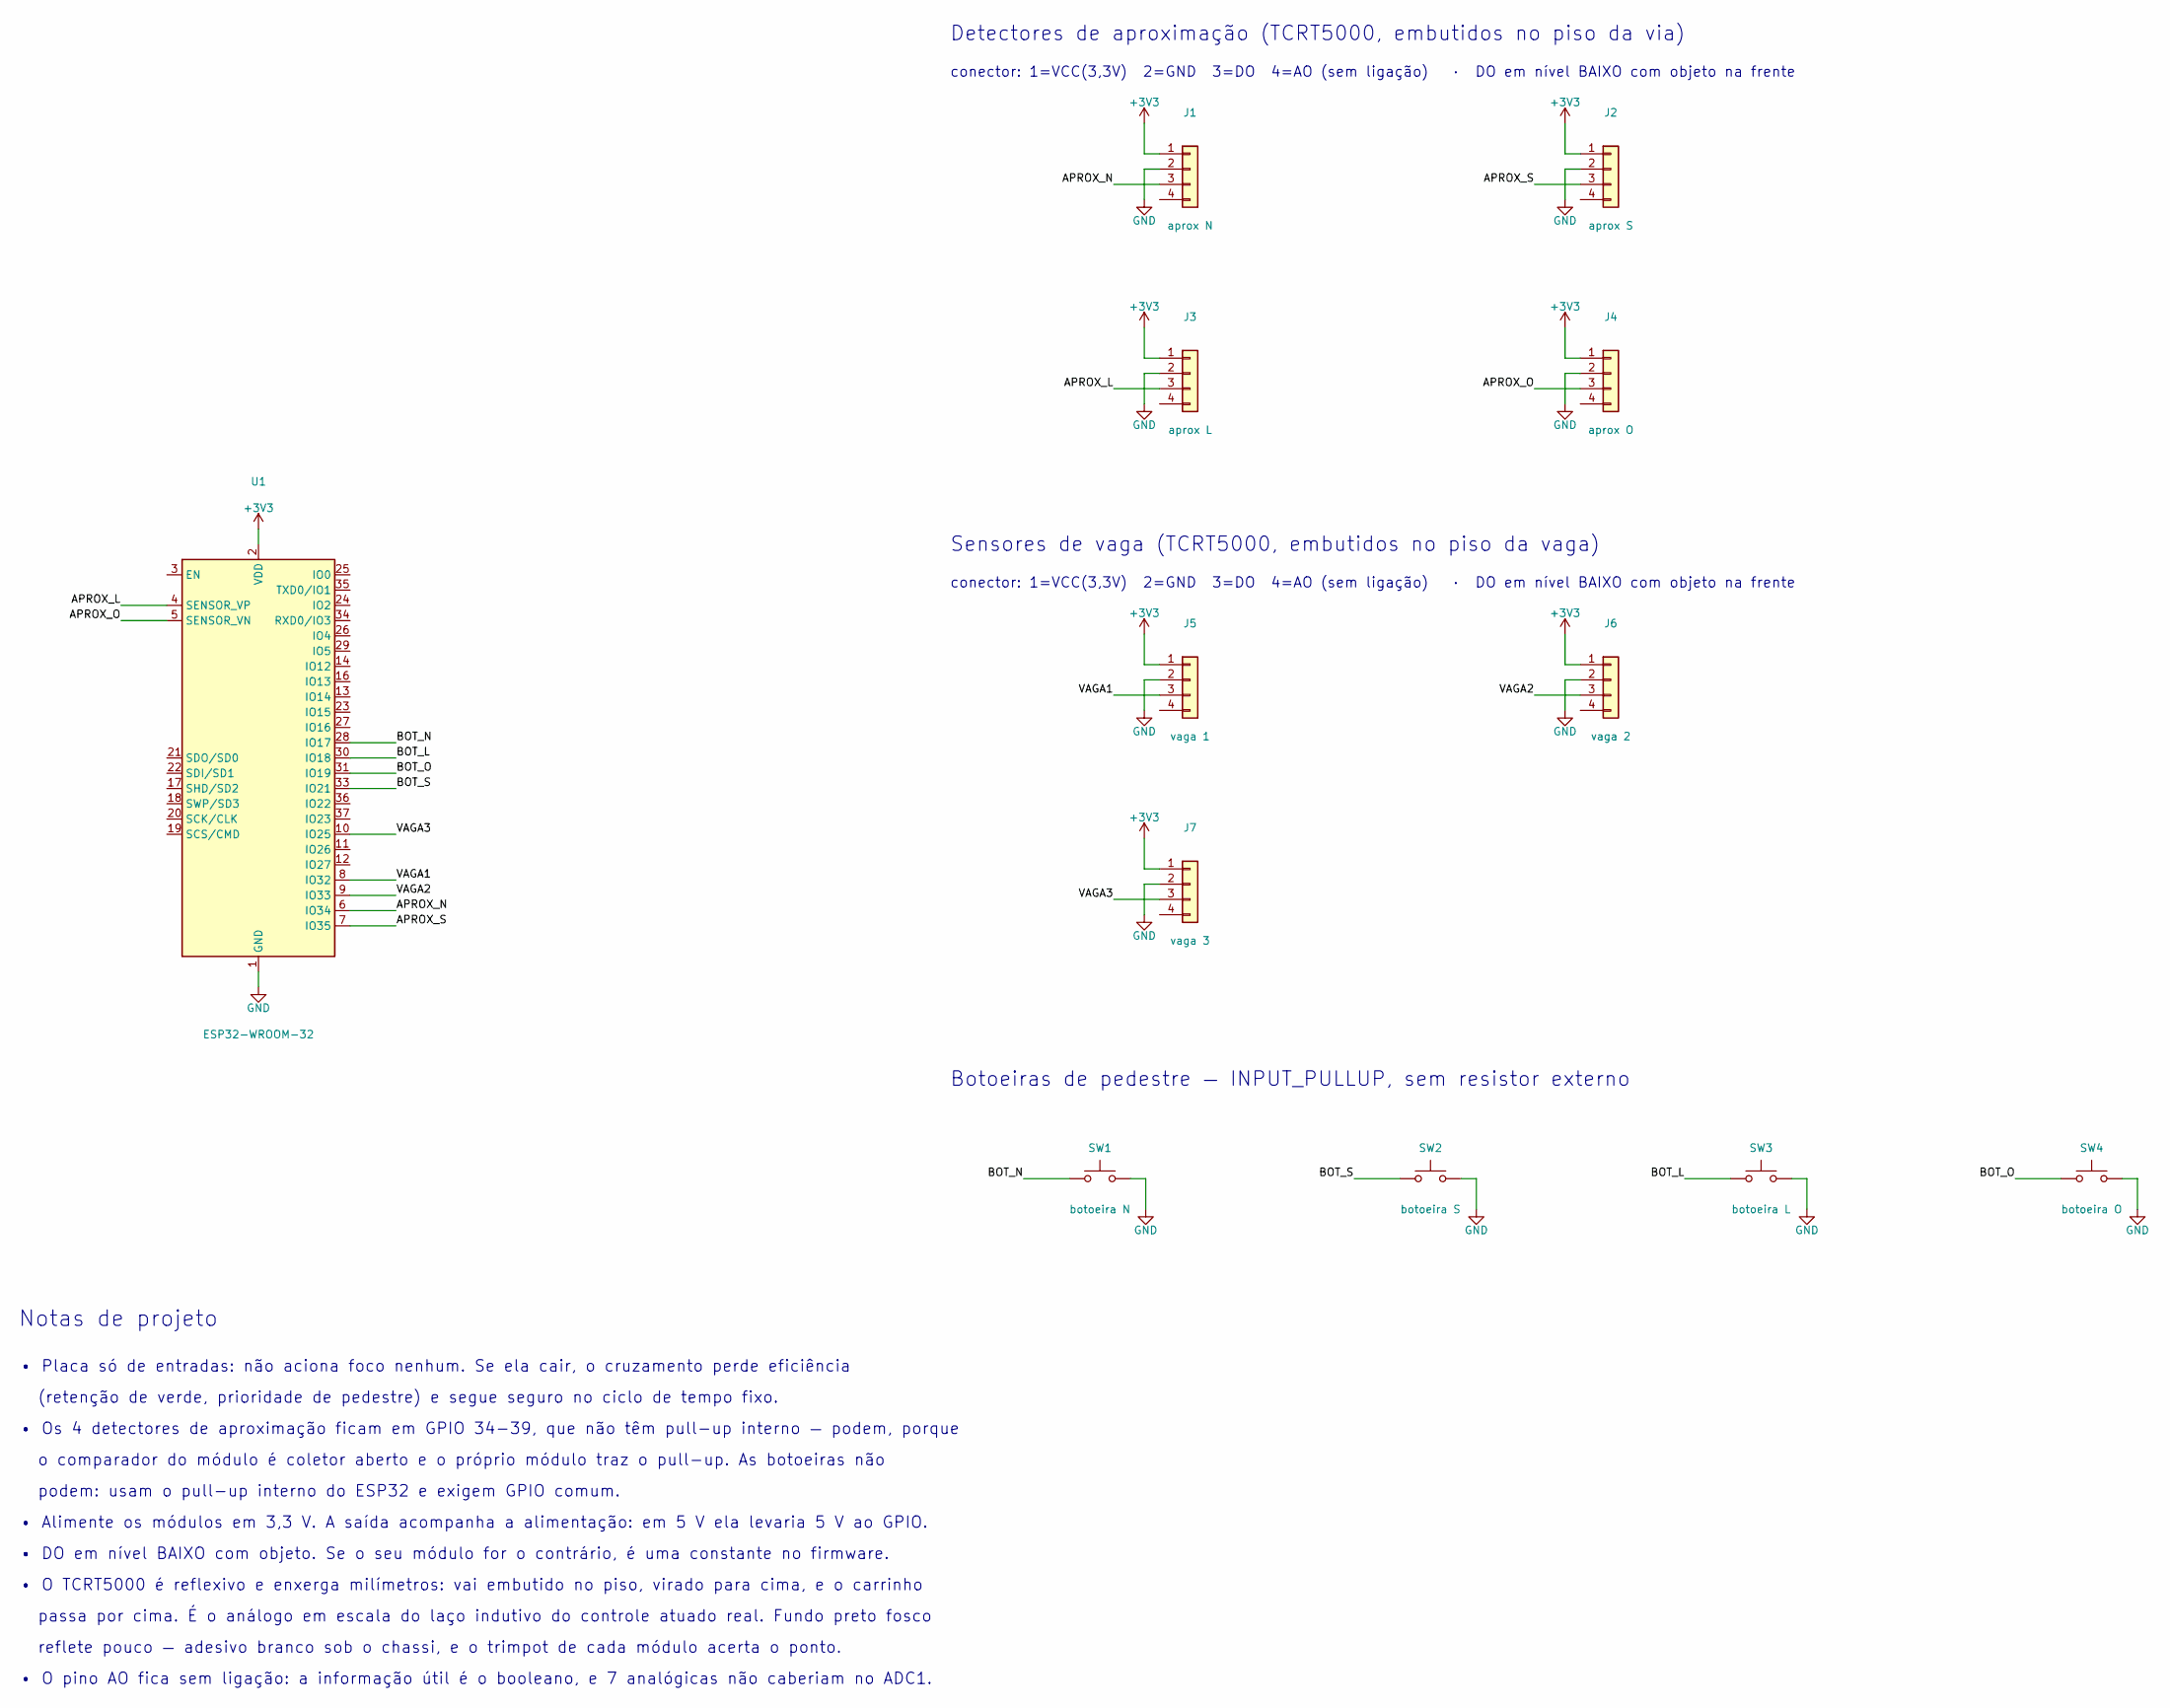
[picture p37: schematic sensores.kicad_sch]

Parts:
J1: aprox N
J2: aprox S
J3: aprox L
J4: aprox O
J5: vaga 1
J6: vaga 2
J7: vaga 3
SW1: botoeira N
SW2: botoeira S
SW3: botoeira L
SW4: botoeira O
U1: ESP32-WROOM-32

Connections:
+3V3: J1.1, J2.1, J3.1, J4.1, J5.1, J6.1, J7.1, U1.2 (VDD)
APROX_L: J3.3, U1.4 (SENSOR_VP)
APROX_N: J1.3, U1.6 (IO34)
APROX_O: J4.3, U1.5 (SENSOR_VN)
APROX_S: J2.3, U1.7 (IO35)
BOT_L: SW3.1, U1.30 (IO18)
BOT_N: SW1.1, U1.28 (IO17)
BOT_O: SW4.1, U1.31 (IO19)
BOT_S: SW2.1, U1.33 (IO21)
GND: J1.2, J2.2, J3.2, J4.2, J5.2, J6.2, J7.2, SW1.2, SW2.2, SW3.2, SW4.2, U1.1 (GND), U1.15 (GND), U1.38 (GND), U1.39 (GND)
VAGA1: J5.3, U1.8 (IO32)
VAGA2: J6.3, U1.9 (IO33)
VAGA3: J7.3, U1.10 (IO25)

Notes on the sheet:
Detectores de aproximação (TCRT5000, embutidos no piso da via)
conector: 1=VCC(3,3V) 2=GND 3=DO 4=AO (sem ligação) · DO em nível BAIXO com objeto na frente
Sensores de vaga (TCRT5000, embutidos no piso da vaga)
Botoeiras de pedestre — INPUT_PULLUP, sem resistor externo
Notas de projeto
• Placa só de entradas: não aciona foco nenhum. Se ela cair, o cruzamento perde eficiência
(retenção de verde, prioridade de pedestre) e segue seguro no ciclo de tempo fixo.
• Os 4 detectores de aproximação ficam em GPIO 34-39, que não têm pull-up interno — podem, porque
o comparador do módulo é coletor aberto e o próprio módulo traz o pull-up. As botoeiras não
podem: usam o pull-up interno do ESP32 e exigem GPIO comum.
• Alimente os módulos em 3,3 V. A saída acompanha a alimentação: em 5 V ela levaria 5 V ao GPIO.
• DO em nível BAIXO com objeto. Se o seu módulo for o contrário, é uma constante no firmware.
• O TCRT5000 é reflexivo e enxerga milímetros: vai embutido no piso, virado para cima, e o carrinho
passa por cima. É o análogo em escala do laço indutivo do controle atuado real. Fundo preto fosco
reflete pouco — adesivo branco sob o chassi, e o trimpot de cada módulo acerta o ponto.
• O pino AO fica sem ligação: a informação útil é o booleano, e 7 analógicas não caberiam no ADC1.
