BrunoCoelho98/maquete-iot-cidades-inteligentes/esquematicos/sinaleiras.kicad_sch

## KiCad design esquematicos/sinaleiras.kicad_sch (2026-11-10)

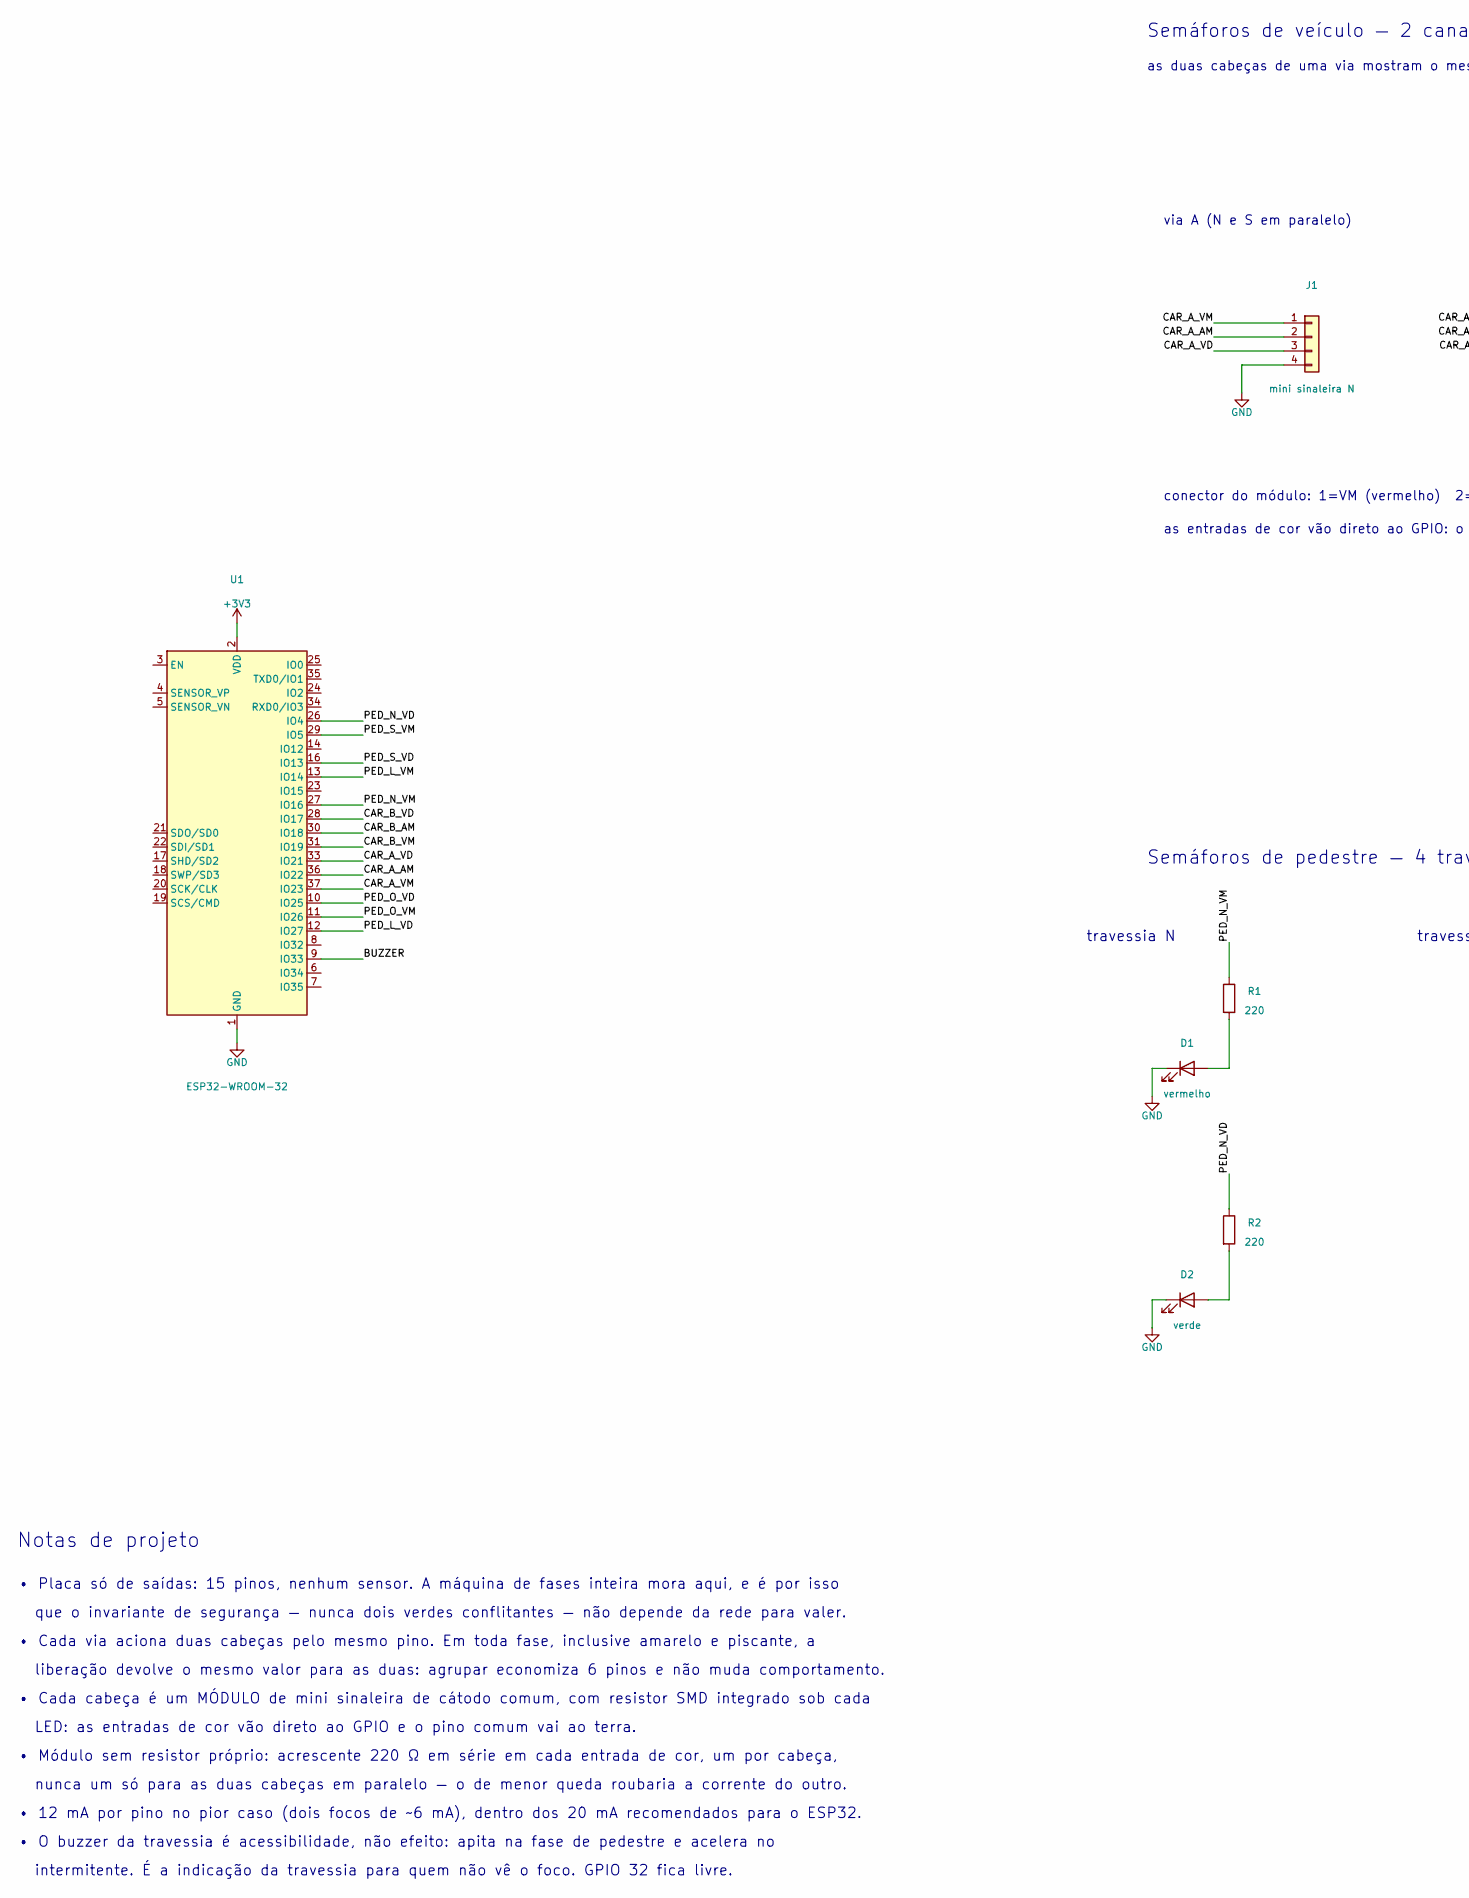
[picture p38: schematic sinaleiras.kicad_sch, part in row 1, column 1]

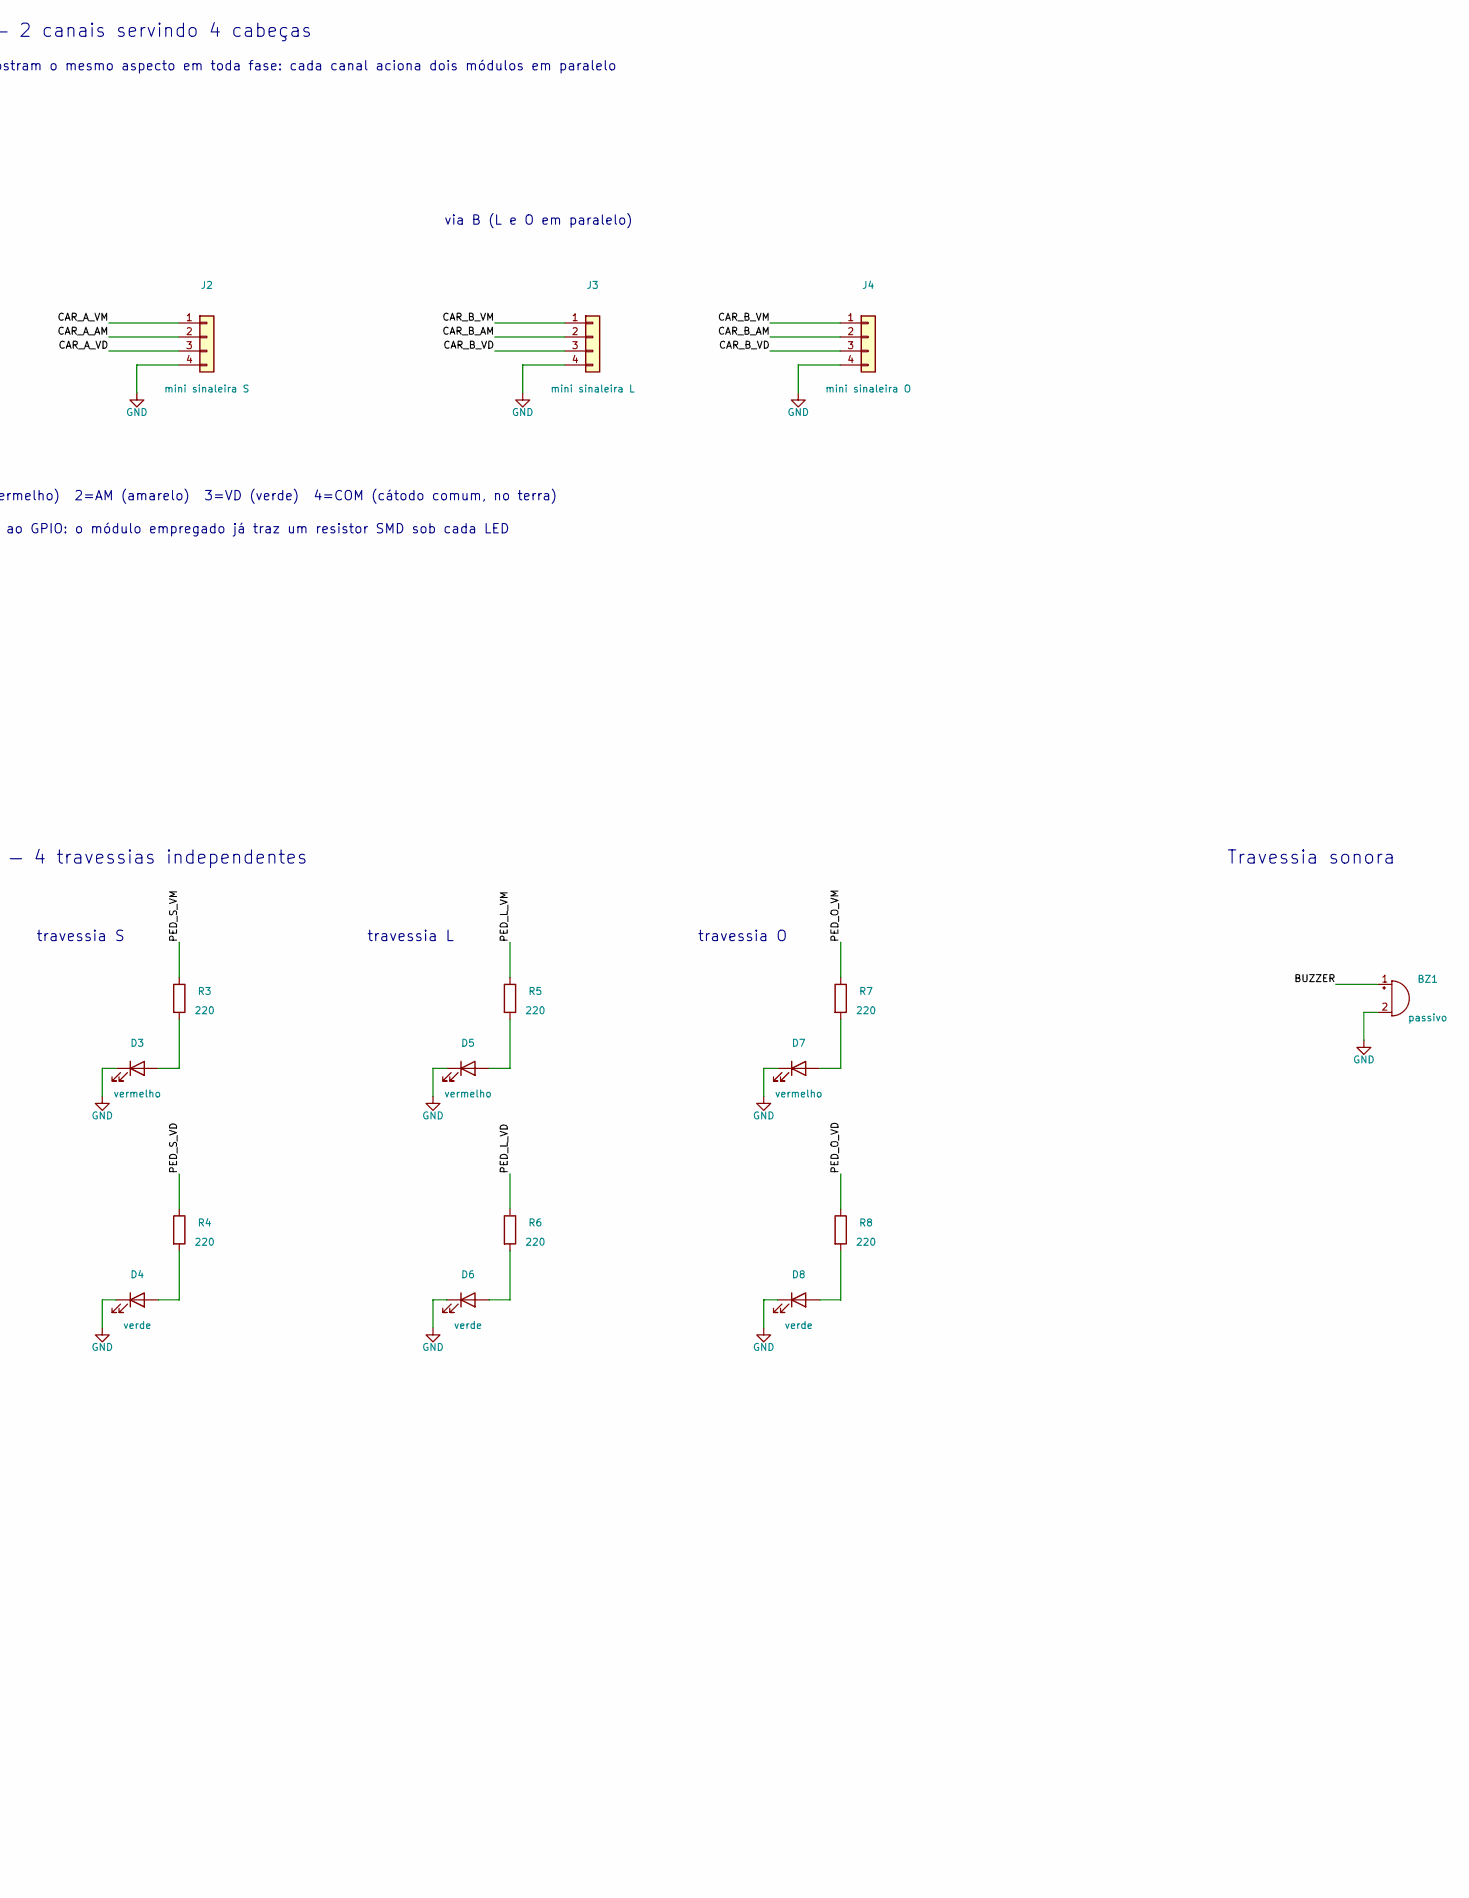
[picture p39: schematic sinaleiras.kicad_sch, part in row 1, column 2]

Parts:
BZ1: passivo
D1, D3, D5, D7: vermelho
D2, D4, D6, D8: verde
J1: mini sinaleira N
J2: mini sinaleira S
J3: mini sinaleira L
J4: mini sinaleira O
R1, R2, R3, R4, R5, R6, R7, R8: 220
U1: ESP32-WROOM-32

Connections:
+3V3: U1.2 (VDD)
BUZZER: BZ1.1 (+), U1.9 (IO33)
CAR_A_AM: J1.2, J2.2, U1.36 (IO22)
CAR_A_VD: J1.3, J2.3, U1.33 (IO21)
CAR_A_VM: J1.1, J2.1, U1.37 (IO23)
CAR_B_AM: J3.2, J4.2, U1.30 (IO18)
CAR_B_VD: J3.3, J4.3, U1.28 (IO17)
CAR_B_VM: J3.1, J4.1, U1.31 (IO19)
GND: BZ1.2 (-), D1.1 (K), D2.1 (K), D3.1 (K), D4.1 (K), D5.1 (K), D6.1 (K), D7.1 (K), D8.1 (K), J1.4, J2.4, J3.4, J4.4, U1.1 (GND), U1.15 (GND), U1.38 (GND), U1.39 (GND)
unnamed: D1.2 (A), R1.2
unnamed: D2.2 (A), R2.2
unnamed: D3.2 (A), R3.2
unnamed: D4.2 (A), R4.2
unnamed: D5.2 (A), R5.2
unnamed: D6.2 (A), R6.2
unnamed: D7.2 (A), R7.2
unnamed: D8.2 (A), R8.2
PED_L_VD: R6.1, U1.12 (IO27)
PED_L_VM: R5.1, U1.13 (IO14)
PED_N_VD: R2.1, U1.26 (IO4)
PED_N_VM: R1.1, U1.27 (IO16)
PED_O_VD: R8.1, U1.10 (IO25)
PED_O_VM: R7.1, U1.11 (IO26)
PED_S_VD: R4.1, U1.16 (IO13)
PED_S_VM: R3.1, U1.29 (IO5)

Notes on the sheet:
Semáforos de veículo — 2 canais servindo 4 cabeças
as duas cabeças de uma via mostram o mesmo aspecto em toda fase: cada canal aciona dois módulos em paralelo
Semáforos de pedestre — 4 travessias independentes
travessia N
travessia S
travessia L
travessia O
Travessia sonora
Notas de projeto
• Placa só de saídas: 15 pinos, nenhum sensor. A máquina de fases inteira mora aqui, e é por isso
que o invariante de segurança — nunca dois verdes conflitantes — não depende da rede para valer.
• Cada via aciona duas cabeças pelo mesmo pino. Em toda fase, inclusive amarelo e piscante, a
liberação devolve o mesmo valor para as duas: agrupar economiza 6 pinos e não muda comportamento.
• Cada cabeça é um MÓDULO de mini sinaleira de cátodo comum, com resistor SMD integrado sob cada
LED: as entradas de cor vão direto ao GPIO e o pino comum vai ao terra.
• Módulo sem resistor próprio: acrescente 220 Ω em série em cada entrada de cor, um por cabeça,
nunca um só para as duas cabeças em paralelo — o de menor queda roubaria a corrente do outro.
• 12 mA por pino no pior caso (dois focos de ~6 mA), dentro dos 20 mA recomendados para o ESP32.
• O buzzer da travessia é acessibilidade, não efeito: apita na fase de pedestre e acelera no
intermitente. É a indicação da travessia para quem não vê o foco. GPIO 32 fica livre.
via A (N e S em paralelo)
via B (L e O em paralelo)
conector do módulo: 1=VM (vermelho) 2=AM (amarelo) 3=VD (verde) 4=COM (cátodo comum, no terra)
as entradas de cor vão direto ao GPIO: o módulo empregado já traz um resistor SMD sob cada LED
