BrunoCoelho98/maquete-iot-cidades-inteligentes/(commit log)

2026-11-04 Segurança: estado FALHA com bipe próprio para sensor desconectado
2026-11-04 README: estado FALHA da placa de segurança
2026-11-10 Esquemáticos: mini sinaleiras na placa 1A, divisor 1k/2k na placa 4, LED do poste com 100 Ω
    Alinha os esquemáticos KiCad ao texto do TCC e ao MATERIAIS.md; README do diretório cita as versões simplificadas em png/.
    [iluminacao.kicad_sch, seguranca.kicad_sch, sinaleiras.kicad_sch]
2026-11-10 README e passo a passo: GPIO das botoeiras e resistores das mini sinaleiras
